zerberros/Class_D_Amp/Proyecto_Fin_de_Grado_Etapa_Amplificadora_de_Clase_D_Jairo_Estefania.pdf

## ESCUELA TÉCNICA SUPERIOR DE INGENIEROS INDUSTRIALES Y DE TELECOMUNICACIÓN

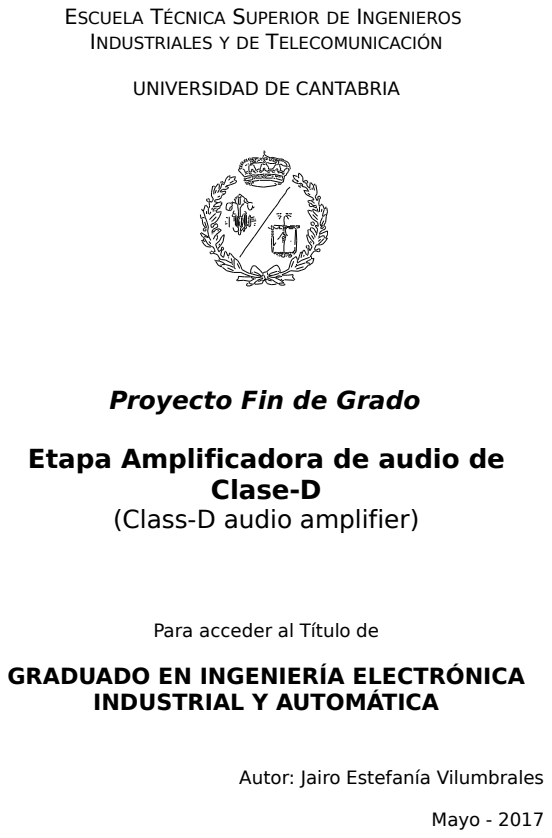
[picture p2: page 1]
Clase-D; INDUSTRIAL Y AUTOMÁTICA; Mayo - 2017

UNIVERSIDAD DE CANTABRIA

Proyecto Fin de Grado
Etapa Amplificadora de audio de

(Class-D audio amplifier)

Para acceder al Título de

GRADUADO EN INGENIERÍA ELECTRÓNICA

Autor: Jairo Estefanía Vilumbrales

Resumen

En este proyecto se ha diseñado y construido una etapa de potencia analógica de clase-D para audio.
Para el diseño, se ha usado un generador de señal triangular basado en un TLC555 y en fuentes de intensidad mediante transistores BJT. Seguidamente la señal es adaptada con algunos amplificadores operacionales y puertas lógicas. Para controlar los MOSFETs de potencia se han usado drivers de la familia ir2010. Finalmente, la señal es integrada mediante un filtro pasivo formado por 2 bobinas toroidales y unos condensadores. Es un prototipo muy versátil ya que con pocos cambios se puede conseguir pasar de una etapa mono a una estéreo. Además la potencia depende de la tensión en la fuente de alimentación y está limitada fundamentalmente de los disipadores de calor y los propios MOSFETs, por lo que también se puede adaptar a diferentes necesidades.
Por último cabe destacar que este proyecto no trata de la construcción de un equipo de audio completo, sino de sólo de la etapa de potencia, y es necesario añadir una fuente de alimentación, una etapa preamplificadora, y una suerte de salida formada una o varias cajas con sus correspondientes altavoces y sus filtros pasivos.

1

2

## Índice

I MEMORIA | 5
II ANEXOS | 25
III PLIEGO DE CONDICIONES | 81
IV PRESUPUESTO | 85

3

4

# Documento I

# MEMORIA

1

Jairo Estefanía | Amplificador de clase D

# Índice general

I MEMORIA | 1
1. Estado del arte | 5
2. Objeto | 7
3. Alcance | 8
4. Normas y referencias | 9
5. Definiciones y abreviaturas | 10
6. Requisitos de diseño | 11
7. Metodología | 12
8. Resultados finales | 18
9. Resumen del presupuesto | 19
mayo 2017 | Documento nº 1: Memoria | página 3 de 19

Jairo Estefanía | Amplificador de clase D
mayo 2017 | Documento nº 1: Memoria | página 4 de 19

Jairo Estefanía | Amplificador de clase D


Figura 1.1: Prototipo. Parte frontal

# 1 Estado del arte

Los amplificadores de transistores empezaron a comercializarse en los años 70. Desde entonces han sufrido una serie de lentos pero constantes cambios que llegan hasta nuestros días, y hoy en día, continúa siendo una tecnología que sigue evolucionando.

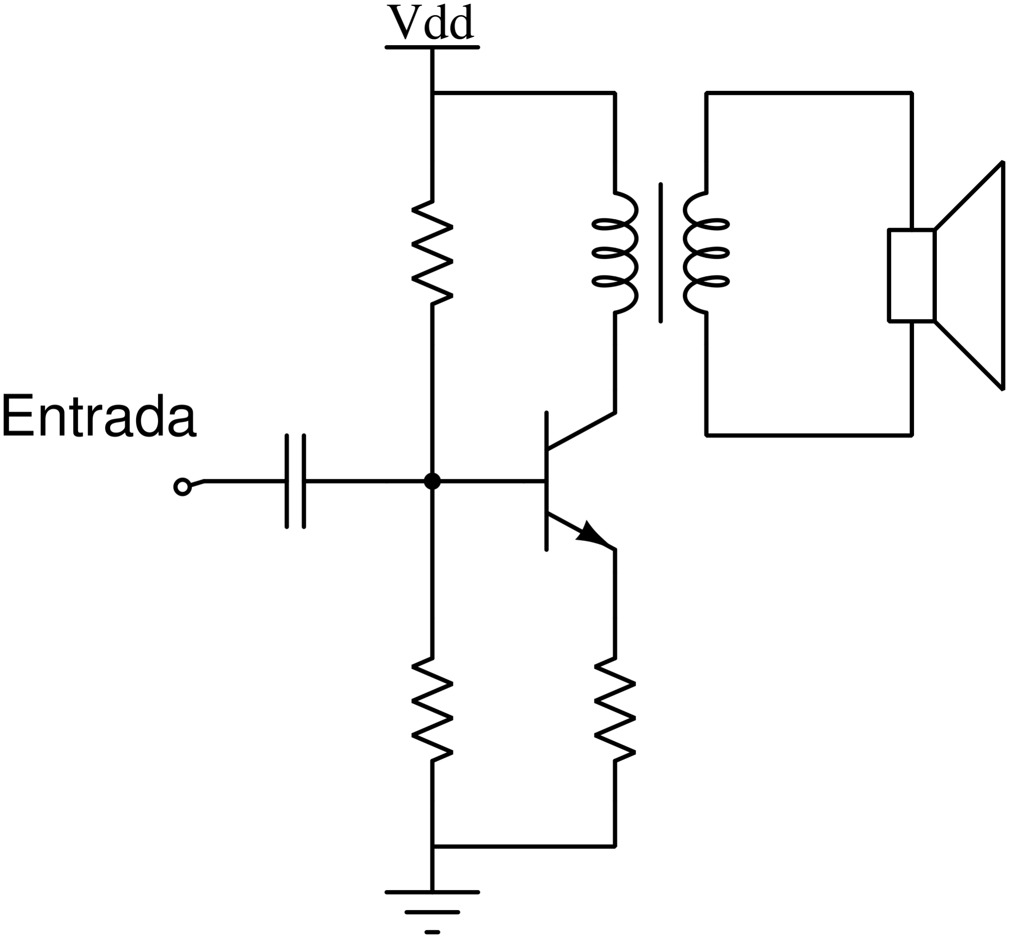
[picture p3: figure]

Figura 1.3: Amplificador de Clase-A

Los amplificadores o etapas de potencia son las encargadas de recibir una señal de un previo o preamplificador, amplificarla y acondicionarla para entregar la señal a los altavoces en forma de potencia. Debido a que los altavoces tienen por norma general una impedancia de 8Ω, las etapas de potencia deberán tener a su vez una una impedancia de salida pequeña, idealmente la misma que el altavoz, para poder entregar el máximo de potencia. Ver teorema de máxima transferencia de potencia [1].

mayo 2017 | Documento nº 1: Memoria | página 5 de 19

Jairo Estefanía | Amplificador de clase D

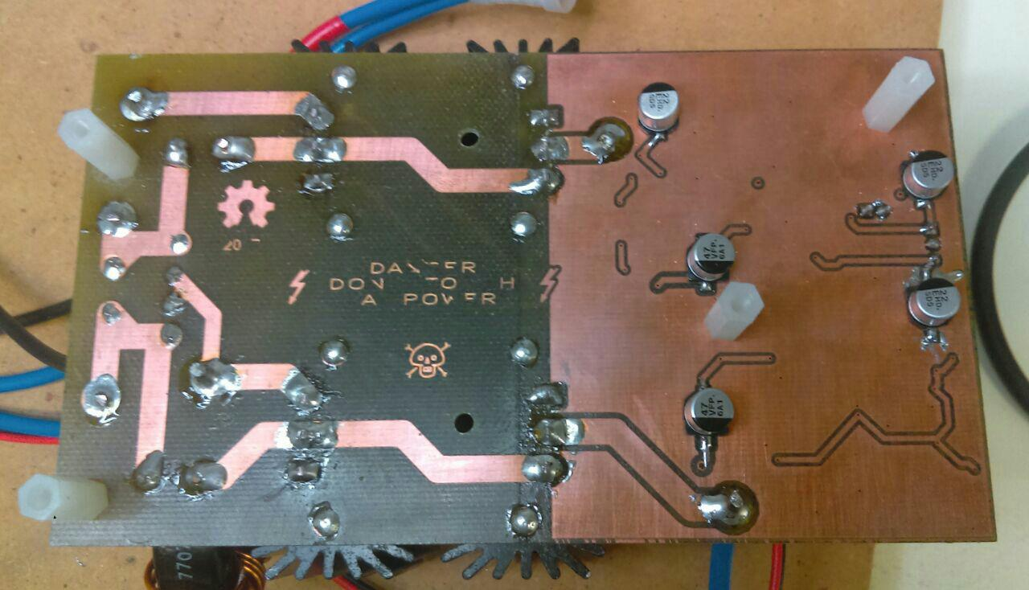
[picture p4: figure]

Figura 1.2: Prototipo. Parte trasera.

Los amplificadores Clase-A tienen una
alta linealidad pero poseen un rendimiento máximo del 50 %, y en algunos modelos con un rendimiento por debajo del 25 % por lo que su utilización se restringe a aplicaciones de menos de 1W, donde el rendimiento no es importante, o donde se necesite una gran linealidad [2].

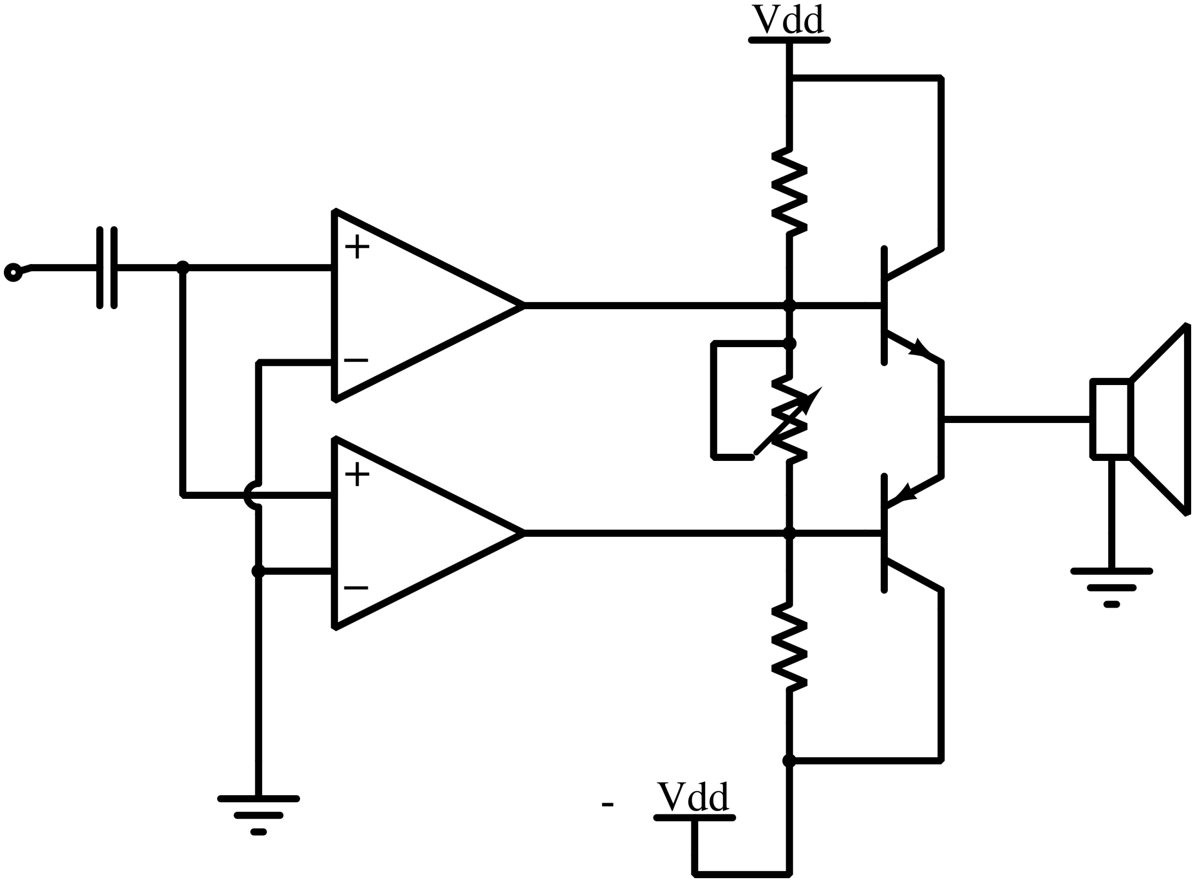
[picture p5: figure]
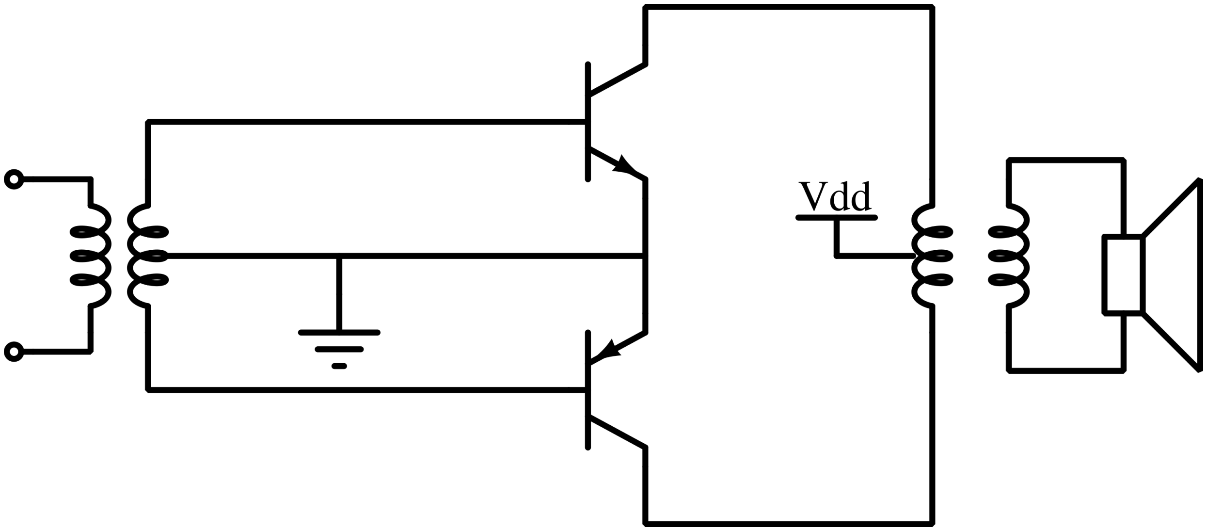
[picture p6: figure]

(a) Amplificador de Clase-B | (b) Amplificador de Clase-AB

Figura 1.4: Etapas de audio

En los amplificadores de Clase-B el rendimiento aumenta hasta el 78 % debido a que los transistores están polarizados en corte y cada transistor trabaja en un semiciclo de la señal de audio. Los amplificadores de Clase-B tienen una molesta distorsión por cruze que hace que en la práctica, no sean utilizados.

Los amplificadores de Clase-AB han sido y siguen siendo los más utilizados tanto en equipos profesionales como en equipos de consumo. Posee un gran compromiso entre linealidad y rendimiento. Su rendimiento es similar

mayo 2017 | Documento nº 1: Memoria | página 6 de 19

Jairo Estefanía | Amplificador de clase D

al de Clase-B 78.5 % sin embargo al polarizarse los transistores, se consigue mitigar la distorsión de cruze.

Los amplificadores de Clase-D han conseguido penetrar en un mercado donde los amplificadores de clase AB no lo han conseguido precisamente por su rendimiento. Esto son la microelectrónica para dispositivos móviles o con bateria, y el audio de alta potencia profesional, dirigido a eventos en directo, donde se usan etapas de más de 5000W.

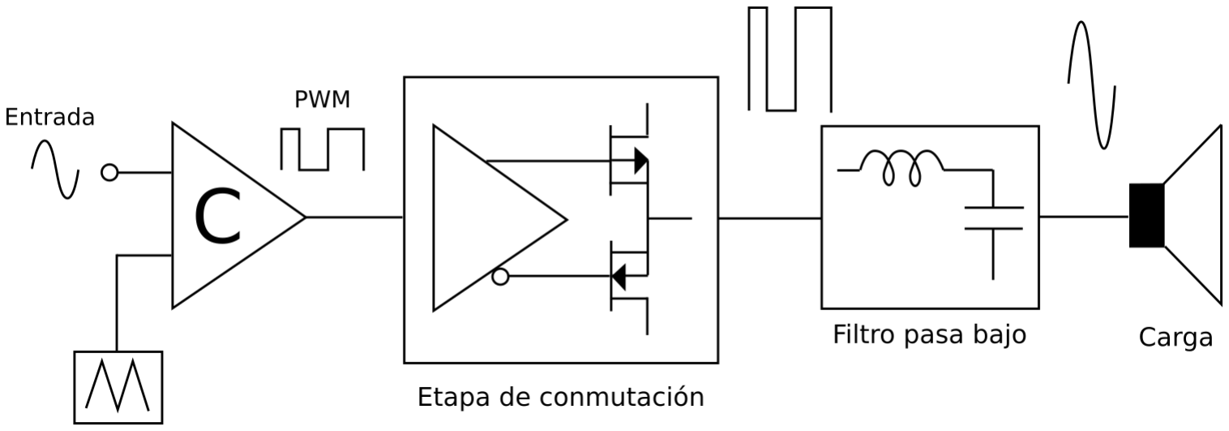
[picture p7: figure]

Figura 1.5: Esquema de funcionamiento de una etapa de clase-D. Fuente: Wikipedia

El funcionamiento de las etapas de clase D difiere por completo de las demás tipos de etapas. Su funcionamiento se basa en el muestreo o troceado de una señal de audio para obtener un mayor rendimiento en los transistores finales de salida. La frecuencia de muestreo debe ser mayor a las frecuencias de la banda de audio, para poder ser eliminada en un filtrado posterior sin que afecte a la calidad final.

Para conseguir el muestreo de audio, se pueden usar varias técnicas, cada una con sus convenientes e inconvenientes. Una de ellas consiste en ir comparando la señal de audio con una señal triangular para obtener una modulación PWM del sonido. Otra técnica consiste en utilizar un modulador Sigma-Delta para conseguir el mismo efecto.

# 2 Objeto

El presente proyecto abarca el diseño, simulación, y prototipado de una etapa amplificadora de audio de clase D, de mediana potencia y de propósito general.
Debido a la complejidad general, el proyecto ha sido dividido en 4 bloques funcionales, que son descritos brevemente a continuación:

Generador de señal triangular: Este bloque genera una señal triangu-

mayo 2017 | Documento nº 1: Memoria | página 7 de 19

Jairo Estefanía | Amplificador de clase D

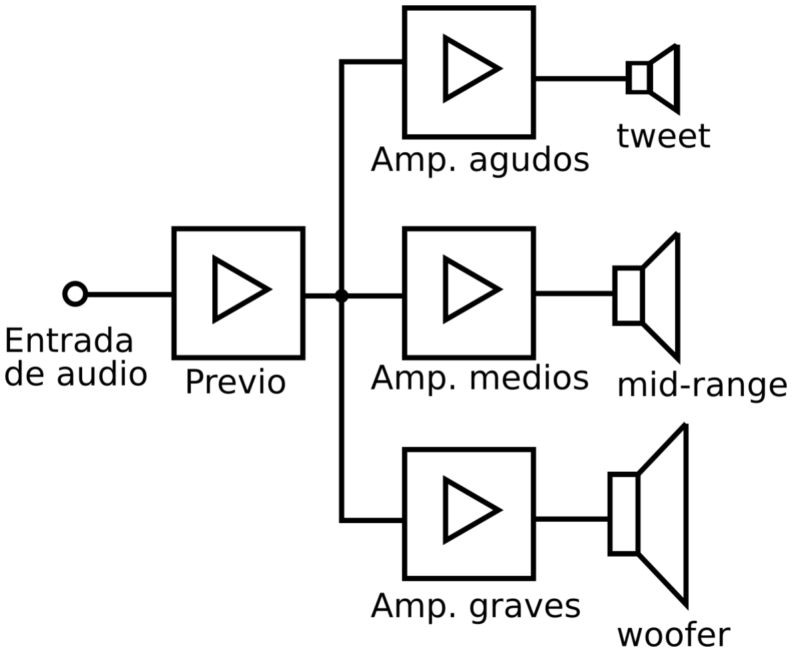
[picture p8: figure]

(a) Varias etapas con filtros activos

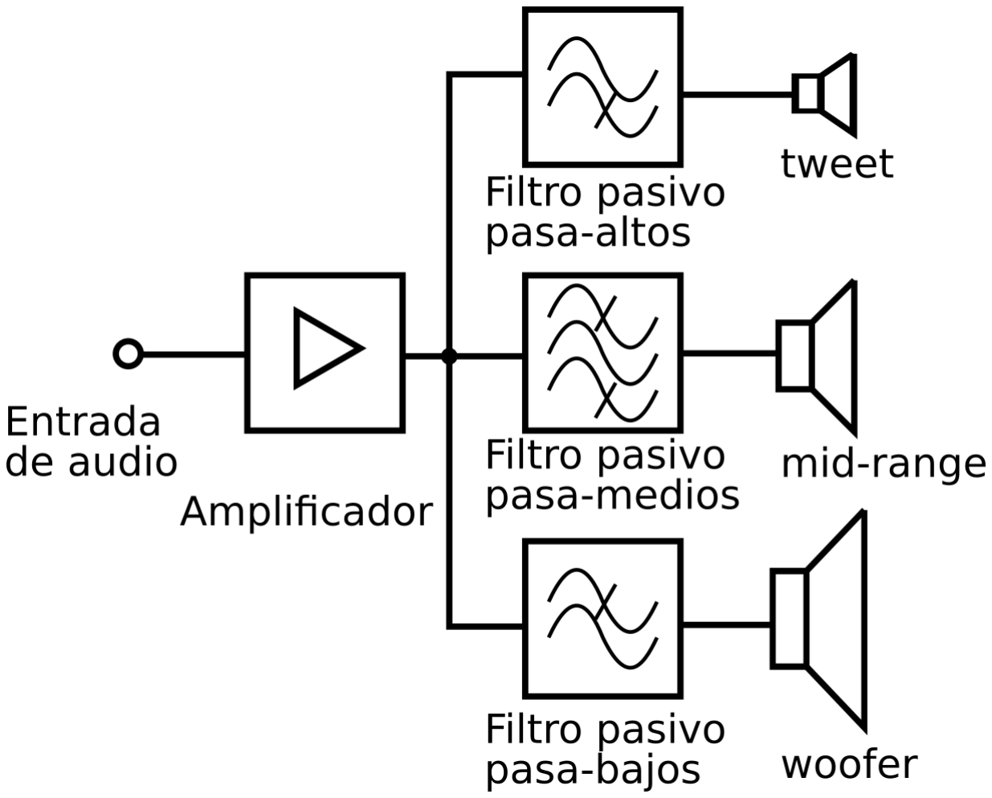
[picture p9: figure]

(b) Etapa con filtros pasivos

Figura 1.6: Sistemas de audio

lar de 5Vpp y 165kHz mediante dos fuentes de intensidad creadas con transistores BJT y gobernadas por un circuito integrado TLC555.

Generador de señales PWM: En esta segunda etapa, por una parte, se filtra la señal triangular para eliminar la componente contínua, y por otra parte, se recoge la señal de audio y se replica con ganancia −1. Finalmente se comparan las 2 señales de audio con la señal triangular para obtener 2 señales PWM, de las cuales, una está invertida y desplazada 180º.

Generador de tiempos muertos: Cada una se las señales PWM es replicada con ganancia −1 y se le añade unos ’tiempos muertos’ con el fin de evitar cortocircuitos de corriente en los MOSFETs de potencia.

Drivers y MOSFETs de potencia: Este bloque contiene 2 amplificadores TODO-NADA formado cada uno por un driver y 2 MOSFETs de tipo N. Los MOSFETs de cada amplificador deben conducir de manera alternativa para generar una señal PWM con la tensión de alimentación. Finalmente las 2 señales PWM de los 2 amplificadores son filtradas con un filtro pasivo formando 2 señales de audio invertidas entre si, que serán las que ataquen al altavoz.

Una vez construido el prototipo, se pretende realizar un análisis de distorsión armónica (THD), un análisis de rendimiento energético, y una valoración económica comparandolo con las diferentes soluciones del mercado.

# 3 Alcance

El alcance de este proyecto es el de poder incorporar ésta etapa de potencia en un equipo profesional o semiprofesional junto a una etapa preamplificadora, una fuente de alimentación y un sistema de salida de 3 o cuatro

mayo 2017 | Documento nº 1: Memoria | página 8 de 19

Jairo Estefanía | Amplificador de clase D

vias de audio con sus respectivos filtros pasivos.

Además se pretenden conseguir unos objetivos en cuanto al enriquecimiento personal:

Adquirir una idea sobre el estado actual del mercado de audio.

Adquirir habilidades necesarias para seguir construyendo productos relaccionados con el audio.

Obtener un producto preparado para competir en el mercado, y que sea fácilmente adaptable a diferentes productos finales (amplificador de guitarra, sistema estéreo autoamplificado, etc).

# 4 Normas y referencias

## 4.1. Disposiciones legales y normas aplicadas

### 4.1.1. Documentación

Normativa del Trabajo Fin de Grado, Universidad de Cantabria, 2013.

Normas Redaccion TFG Grado en Ingeniería Mecánica, Eléctrica y Electrónica Industrial y Automática

Norma UNE 157001-2014

### 4.1.2. Normas técnicas

Generic Standard on Printed Board Design [5]

IEEE Recommended Practice and Requirements for Harmonic Control in Electric Power Systems

## 4.2. Software

NGSPICE 26: Software para la simulación de circuitos electrónicos. Desarrollado inicialmente por la Universidad de California en Berkeley, y actualmente mantenido por una pequeña comunidad de software libre. Licencia BSD.

Python 3.6: Software utilizado para cálculos matemáticos y scripting, junto a las bibliotecas Jupyter, numpy, matplotlib, y Scipy. Licencias: PSF LICENSE (GPL-compatible), y derivadas.

mayo 2017 | Documento nº 1: Memoria | página 9 de 19

Jairo Estefanía | Amplificador de clase D

KiCad 4.0.6: Software utilizado para la creación de esquemáticos y diseño de PCB. Licencia GPL 3+.

LATEX 2ε: (ecosistema) Software utilizado para la documentación. Licencia MIT, LGPL, LaTeX Project Public License (LPPL), GPL.

FreeCad 0.16 Software de diseño 3D usado para crear algunos modelos 3D de componentes para KiCad.

Inkscape 0.92 Software de dibujo vectorial en 2D utilizado para la documentación. Licencia GPL.

git 2.12 Sistema de control de versiones. Licencia GPL v.2

## 4.3. Bibliografia

[1] V. M. y. O. Parra, TEORÍA DE CIRCUITOS I y II, U. Madrid, ed. 1991.
[2] J. C. Ginés, Equipos de sonido, E. C. 3, ed. 2001, isbn: 84-95391-82-1.
[3] R. Palmer, «Design Considerations for Class-D Audio Power Amplifiers», Texas Instruments, Application Report, ago. de 1999.
[4] R. W. Erickson y D. Maksimović, Fundamentals of Power Electronics. Kluwer academic, 2001, isbn: 0-7923-7270-0, 0-306-48048-4.
[5] I.-A. C. E. Industries, ed., IPC-2221, Generic Standard on Printed Board Design, feb. de 1998. dirección: www.ipg.org.
[6] B. Carter y R. Mancini, OP AMPS for everyone, T. Instruments, ed. 2009, isbn: 978-1-85617-505-0.
[7] W. N. Mohan T.M. Undeland, Power electronics.: converters, applications and design, J. Wiley, ed. 1995, isbn: 0-471-58408-8.
[8] J. Honda y J. Cerezo, «Class D Audio Amplifier Design», International rectifier, Application Report, 2003.

# 5 Definiciones y abreviaturas

Bridge mode: Configuración en puente: Sistema incorporado en etapas de potencia estéreo en el que uno de los canales se invierte de fase para alimentar sólo una salida, convirtiendo el sistema en mono y sumando en éste la potencia de los dos canales.

mayo 2017 | Documento nº 1: Memoria | página 10 de 19

Jairo Estefanía | Amplificador de clase D

Driver para MOSFETs: Circuito integrado encargado de generar tiempos muertos y/o cambiar la referencia de la señal en entrada, por la tensión de fuente del MOSFET, en los casos en los que la tensión de esta patilla sea diferente a GND.

Duty Cycle: Ciclo de Trabajo: Es la relación que existe entre el tiempo en que una señal PWM se encuentra en estado activo y el periodo de la misma.

K.I.S.S.: Keep It Simple Stupid : Filosofia de diseño originaria en la armada de los E.E.U.U. por los años 60, que reza que hay que mantener las cosas lo más simple posible, aunque parezca estúpido, con el fin de facilitar un buen mantenimiento y detección de errores.

PCB: Placa de Circuito Impreso: Es la superficie constituida por caminos, pistas o buses de material conductor laminadas sobre una base no conductora.

PWM: Modulación por Ancho de Pulsos: Es una técnica en la que se modifica el ciclo de trabajo de una señal cuadrada, para preansportar una información.

RMS: Valor Cuadrático Medio o valor eficaz: Es la raíz cuadrada de la media aritmética de los cuadrados de los valores. Se corresponte con
√

1
(2)

veces el valor pico de una señal de tensión o intensidad.

THD: Distrosión Armónica Total: Es un parámetro técnico utilizado para definir la cantidad de armónicos que el equipo introduce y que no estaban en la señal original.

# 6 Requisitos de diseño

## 6.1. Diseño ético

Todo el proyecto ha sido diseñado con software libre, y será liberado para que pueda ser estudiado por otras personas. De esta forma se contempla que en un futuro pueda existir un desarrollo del mismo a una mayor velocidad y con diferentes puntos de vista.

mayo 2017 | Documento nº 1: Memoria | página 11 de 19

Jairo Estefanía | Amplificador de clase D

## 6.2. Diseño estratégico

El proyecto se ha dividido en subcircuitos más pequeños en forma de módulos siguiendo el principio K.I.S.S. que se traduce como, ’mantenlo lo más simple posible’.
Los archivos de simulación y los archivos de los esquemáticos para su posterior proceso hacia el diseño de la PCB están fuertemente correlacionados, de tal forma que se pueda identificar unos con otros.
Por último se ha implementado un sistema de control de versiones medianta Git.

## 6.3. Diseño técnico

La etapa de potencia ha sido diseñada para trabajar con un alto rango de tensiones de entrada.
Por simplicidad sólo se ha contemplado un modo Bridge y una carga de 8Ω. Sin embargo resulta relativamente sencillo adaptar el diseño para hacer un amplificador estéreo, o para poder utilizar altavoces de distinta impedancia.
La PCB ha sido diseñada con tecnología SMD para conseguir la mayor reducción de tamaño posible y poder reducir gastos de fabricación.

# 7 Metodología

## 7.1. Funcionamiento General y modo Bridge

Los amplificadores de potencia de clase D, utilizan MOSFETs o IGBTs a modo de interruptores, que generan unas señales cuadradas que posteriormente se filtran para obtener la señal de audio que atacará a los altavoces. Ya que la carga de las etapas de audio es fija, -normalmente de 8Ω, pero puede ser de 4Ω o 2Ω poniendo varios altavoces en paralelo- , la potencia entregada a la salida depende exclusivamente de la tensión de la señal cuadrada generada por los MOSFETs, y por tanto, de la tensión de alimentación de la etapa.
La razón de utilizar los MOSFETS a modo de interruptores es la de la eficiencia. Cuando un transistor de potencia se encuentra en conducción la tensión entre sus terminales es prácticamente de cero voltios, mientras que si se encuentra en corte, la intensidad que pasa entre sus terminales también es cero. Por lo tanto si aplicamos la fórmula P = V · I, se comprueba que la potencia disipada en los transistores de potencia es mínima, en comparación con la potencia que llega a la carga.
mayo 2017 | Documento nº 1: Memoria | página 12 de 19

Jairo Estefanía | Amplificador de clase D

El modo Bridge consiste en alimentar al altavoz con dos tensiones invertidas respecto a una referencia virtual. Con ésta técnica se consigue alimentar el altavoz con una tensión virtual del doble.
Para hacer una etapa de potencia en modo Bridge es necesario doblar el número de transistores MOSFETS, ya que en vez de regular una tensión respecto a una referencia, se tiene que regular 2 tensiones.
Modulación: Fundamentalmente consiste en comparar una señal triangular a alta frecuencia con la señal de sonido. Dependiendo de el nivel de tensión de la señal de audio en un punto dado, se cortará antes o después con la señal triangular, lo que producirá una señal PWM con un duty cycle determinado.
Para una mejor calidad de sonido , o una mejora del nivel de distorsión armónica, la modulación de los MOSFETS que regulan la tensión de salida positiva, se modulan con la señal de audio sin modificar, mientras que la modulación que regula la tensión de salida negativa, se modula con la señal de audio invertida.

## 7.2. Alimentación

En la parte de control se necesita una alimentación de 15V DC para el TLC555, el disparador Schmitt 40106 y las puertas lógicas ’AND’ 14081. El amplificador operacional TL084 y el comparador LM319 necesitan alimentación dual de ±15V . Los driver ir2010 por un lado llevan 15V DC por la parte de control y otros 15V DC para la parte de potencia. La alimentación de los MOSFETs también debe ser contínua y dependerá de la potencia que se pretenda ofrecer a la salida.

## 7.3. Generador de señal triangular

Para generar una señal triangular se ha utilizado un circuito integrado TLC555 en modo astable, cuya salida se invierte mediante los BJT Q1 y Q8. La señal invertida sirve para polarizar alternativamente los BJT Q2 y Q3 que funcionan a modo de fuente de intensidad. A través de las resistencias R3 y R4 y los 2 diodos zener se obtiene el valor de tensión en puerta deseado para la polarización, en este caso 3,6V . Mediante las resistencias R5 y R6 se regula la fuente de intensidad que se encarga de cargar y descargar el condensador C2 y producir la señal triangular. Cuando la tensión del condensador alcanza 1/3 y 2/3 de Vcc, el TLC555, realimentado por la patilla 6 y 2, invierte su salida.

mayo 2017 | Documento nº 1: Memoria | página 13 de 19

Jairo Estefanía | Amplificador de clase D

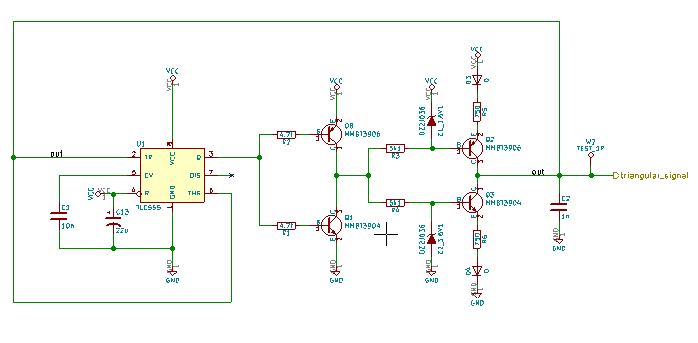
[picture p10: figure]

Figura 7.1: Generador de señal triangular

## 7.4. Generador de señal PWM

### 7.4.1. Adaptación de impedancia y filtrado de componente

contínua en la señal triangular

El amplificador operacional TL084 U2D (Fig: 7.2) es configurado como seguidor de tensión, ya que es necesaria una impedancia idealmente infinita para no producir ningina atenuación en la señal triangular.
El amplificador operacional U2C actúa como filtro pasa-alto, con una ganancia unidad en altas frecuencias y una frecuencia de corte situada aproximadamente en los 1,2KHz con lo que se elimina la componente contínua de la señal.

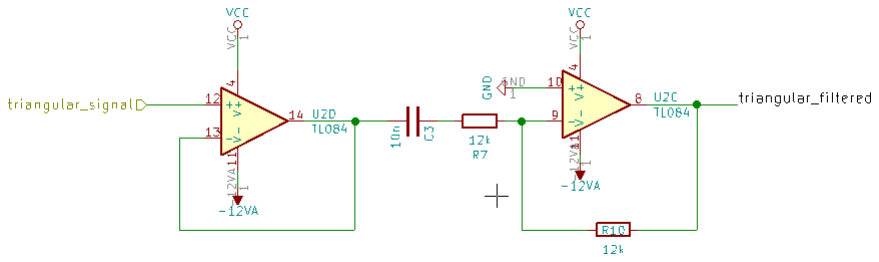
[picture p11: figure]

Figura 7.2: Filtrado de componente contínua a la señal triangular.

mayo 2017 | Documento nº 1: Memoria | página 14 de 19

Jairo Estefanía | Amplificador de clase D

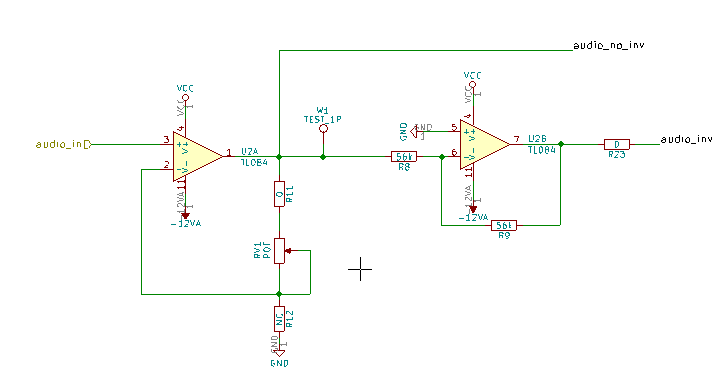
[picture p12: figure]

Figura 7.3: Entrada de audio

### 7.4.2. Entrada de audio

El amplificador operacional U2A (Fig: 7.3) funciona como seguidor de tensión pero cambiando el valor de las resistencias R11 y R12 se puede añadir algo de ganancia, que además se puede ajustar con la resistencia variable
RV 1 [6].
El amplificador operacional U2B (Fig: 7.3) está configurado como amplificador inversor de ganancia unidad. Las resistencias R8 y R9 tienen un valor lo suficientemente alto para no atenuar la señal. La resistencia R23 no tiene ninguna función y está colocada para hacer de puente en la PCB.

### 7.4.3. Comparadores

En la figura 7.4 se observa como se obtiene las señales PWM a partir de la señal triangular y las señales de audio. El circuito integrado LM319 es un comparador con colector abierto, por lo que es necesario colocar las resistencias R13 y R14. La generación de los PWM en fase y en contrafase tiene un sentido, y es que ésta técnica de modulación reduce considerablemente el contenido de armónicos en la salida [7].

## 7.5. Generación de tiempos muertos

Las señales Hinfase y Linfase de la figura 7.5 son las encargadas de conmutar una de las salidas con la tensión de alimentación de potencia V EE y con GNDPW R respectivamente, por lo que en ningún momento pueden estar las 2 en estado alto. Además, debido a que los MOSFETs tienen un tiempo de corte mayor que el de puesta conducción, es necesario introducir un tiempo muerto o ’dead time’ en las transiciones de conducción.

mayo 2017 | Documento nº 1: Memoria | página 15 de 19

Jairo Estefanía | Amplificador de clase D

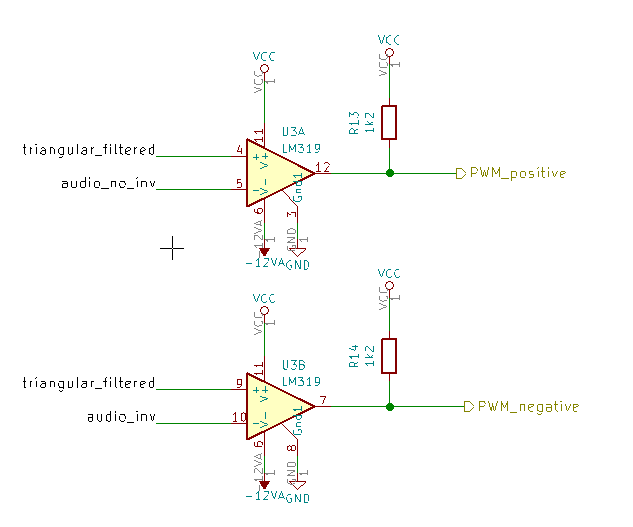
[picture p13: figure]
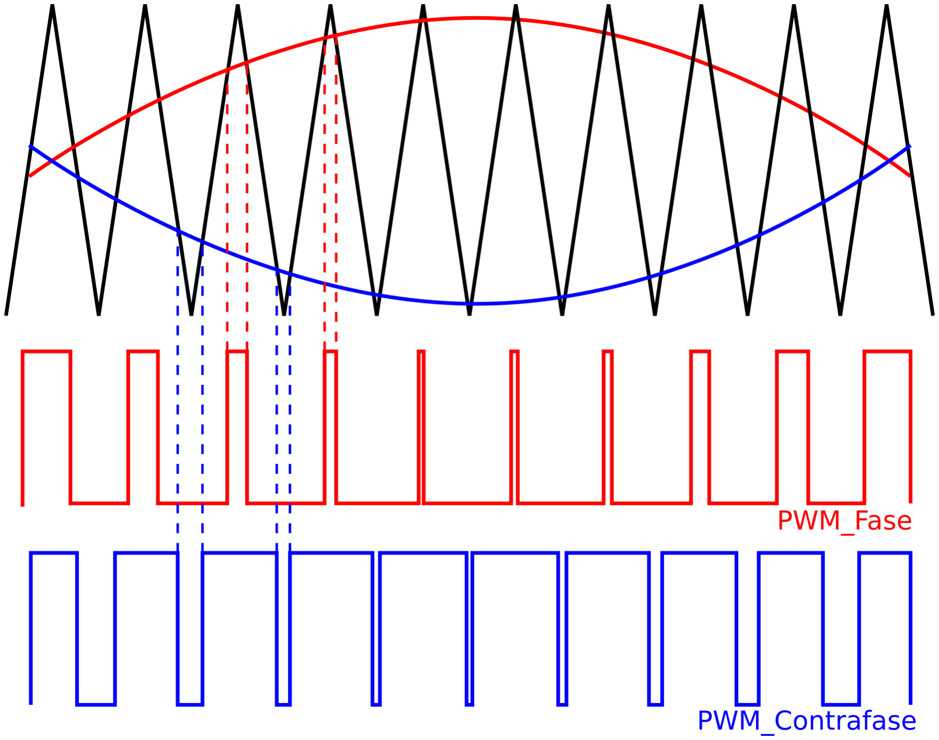
[picture p14: figure]

(a) Comparadores LM319 | (b) Señales PWM a partir de una se- ñal triangular y una señal de audio

Figura 7.4: Generación de PWM mediante comparadores

Para generar los tiempos muertos se usa una red RC y un disparador de Schmitt. Cuando se produce un flanco de subida, el condensador se empieza a cargar con la intensidad limitada mediante la resistencia. Cuando el condensador alcanza la tensión de histéresis del disparador, éste cambia su salida, pudiendose controlar así, los tiempos muertos cambiando los valores del condensador y/o la resistencia. Hay que tener en cuenta que el disparador de Schmitt ofrece una intensidad de salida limitada a 6mA, por lo que se debe tener que poner un valor de resistencia relativamente alto, y un valor de condensador relativamente bajo.
Observese en la figura que para que una de las puertas AND tenga una salida en estado alto, una de las patillas de entrada tiene que estar en estado alto mientras que la otra entrada la misma señal pasa necesariamente por la red RC (y se niega 2 veces.)

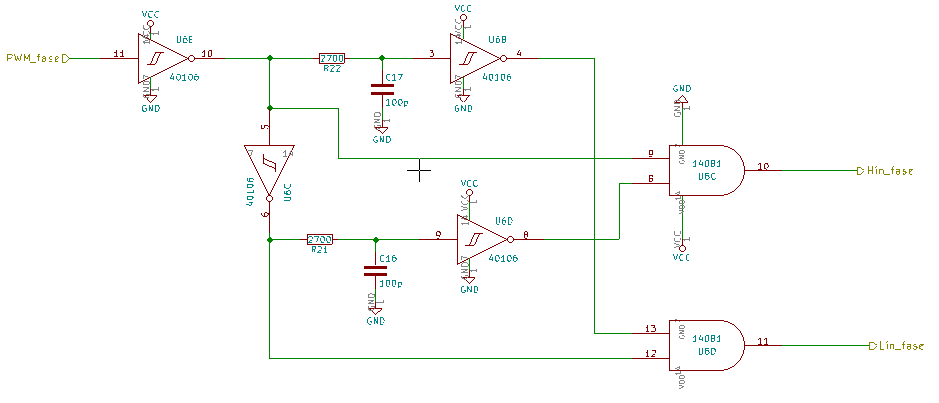
[picture p15: figure]

Figura 7.5: Generación de tiempos muertos.

mayo 2017 | Documento nº 1: Memoria | página 16 de 19

Jairo Estefanía | Amplificador de clase D

## 7.6. Driver de potencia y Mosfets

### 7.6.1. Drivers ir2010

Los drivers tienen 2 funciones fundamentales; La primera es la de poder elevar la referencia de tensión para la tensión de puerta en caso de que el MOSFET se encuentre ’flotando’. La segunda es la de crear un tiempo muerto para que no se produzca cortocircuito en corriente, aunque en este caso, el driver ir2010 no proporciona un tiempo muerto lo suficientemente grande, y es necesario contar con el circuito auxiliar que haga esta función. Para poder mantener una tensión de puerta para el MOSFET alto, el driver se basa en un condensador llamado condensador bootstrap (CBOOT ), y en un diodo, llamado diodo bootstrap (Dbs). Cuando el MOSFET bajo se encuentra conduciendo, la referencia Vs es próxima a cero, y el condensador CBOOT se carga a través del diodo Dbs a la tensión Vcc. Una vez que el MOSFET de abajo entra en corte, la tensión Vs deja de estar a cero voltios, y el condensador CBOOT es descargado a través de VB y HO a la capacidad de puerta del MOSFET alto, haciendo que éste entre en conducción. Ver figura 7.7.

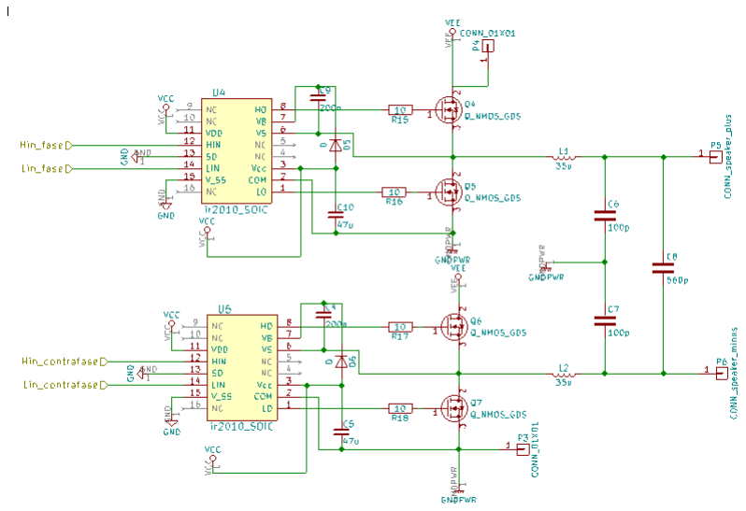
[picture p16: figure]

Figura 7.6: Drivers, MOSFETs e integrador

### 7.6.2. MOSFETs

Como se ha podido observar antes, los MOSFETs son los encargados de crear una conmutación a GNDPW R y a V EE alternativamente para crear una señal PWM de potencia que atacará al altavoz. Por lo tanto la elección

mayo 2017 | Documento nº 1: Memoria | página 17 de 19

Jairo Estefanía | Amplificador de clase D

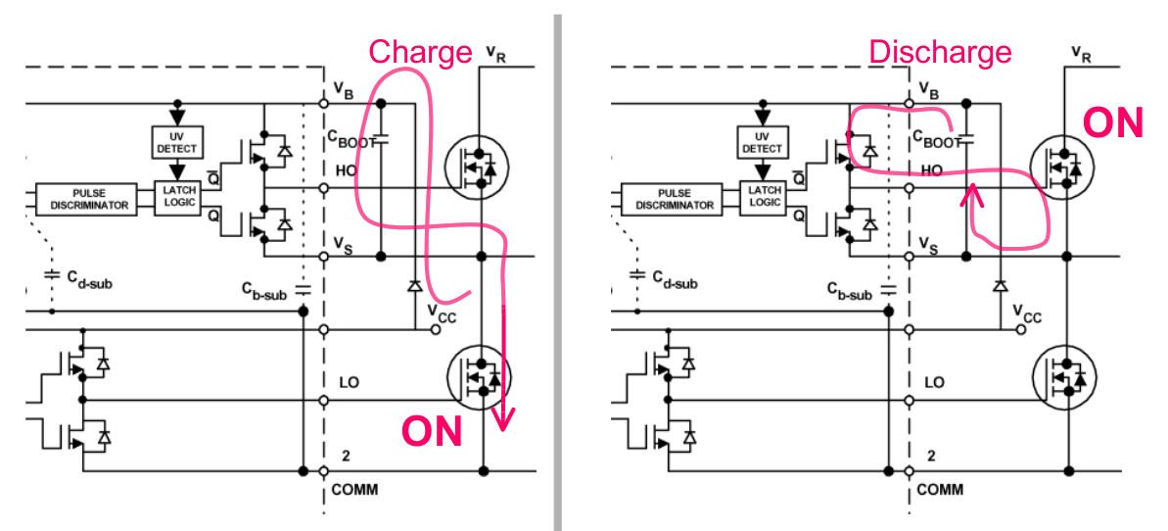
[picture p17: figure]

Figura 7.7: Técnica ’Boot strap’ para la polarización del MOSFET en el lado alto.Imagen del articulo ’Class-D Audio Amplifier Design’ de IR.[8]

de unos MOSFETs de calidad es fundamental para un buen funcionamiento del circuito.
Los parámetros más importantes del MOSFET, son la resistencia de conducción llamada Rdson, y los tiempos de conmutación.
Para este tipo de aplicaciones es crucial que los MOSFETs tengan una resistencia de conducción lo más baja posible ya que éste parámetro indica la cantidad de energía que se va a desperdiciar en forma de calor, y por consiguiente, condiciona el tamaño de los disipadores de calor y el rendimiento del circuito.

### 7.6.3. Filtrado

El objetivo del filtro de salida es la atenuación de la componente de alta frecuencia producido por los MOSFETs preservando la señal en la banda de audio. [3]
Un filtro de segundo orden produce una atenuación de 40dBs por década, lo que significa que se tiene la frecuencia de corte en 25kHz y la frecuencia de conmutación en 165kHz se produce una atenuación de 32,8dBs, o lo que es lo mismo, una señal de 100V se reduce a una señal de 2,32V .
Si se desea incrementar la atenuación, existen dos alternativas: implementar un filtro de mayor orden, o aumentar la frecuencia de conmutación.

# 8 Resultados finales

Tras realizar los pertinentes ensayos en el laboratirio, se ha llegado a la conclusión de que los resultados son sorprendentemente buenos, a pesar de algunos pequeños fallos, y una generación de tiempos muertos excesivamente largos.

mayo 2017 | Documento nº 1: Memoria | página 18 de 19

Jairo Estefanía | Amplificador de clase D

No se ha podido realizar un análisis THD, debido a la dificultad de realizar una medición fiable.

# 9 Resumen del presupuesto

El coste total del proyecto asciende a oncemil ciento cincuenta con doce euros. 11.150,12e

mayo 2017 | Documento nº 1: Memoria | página 19 de 19

# Documento II

# ANEXOS

1

Jairo Estefanía | Amplificador de clase D

# Índice general

II ANEXOS | 1
A. Cálculos | 7

A.9. Potencia máxima en función del driver de los Mosfets . . . . 13

A.11.Potencia máxima en función de la intensidad de drenador de

B. Ficheros de Simulación (ngspice) | 17
C. Ensayos | 29
mayo 2017 | Documento nº 2: Anexos | página 3 de 55

Jairo Estefanía | Amplificador de clase D
C.5.4. 50V | 36
C.6. Carga de 10,8Ω | 37
C.6.1. 40V | 37
C.6.2. 50V | 38
C.6.3. 60V | 39
C.6.4. 70V | 40
C.7. Cámara térmica | 41
C.8. Conclusiones | 41
D. Esquemáticos | 43
Esquema de bloques | 43
Generador de señal triangular | 45
Generador de señales PWM | 46
Generador de tiempos muertos | 47
Drivers y MOSFETS de potencia | 48
E. Ficheros PCB y Gerbers | 49
Capa de cobre ’Top’ | 49
Capa de cobre ’bottom’ | 51
Capa de taladros | 52
Posición de componentes | 52
F. Análisis de competencia | 53
F.1. the t.amp Proline 3000 | 53
F.2. the t.amp E-800 | 53
F.3. Behringer KM750 | 54
F.4. Crown XLS 2500 | 54

# Índice de figuras

A.1. Regulación de fuente de intensidad | | 7
A.2. Generador de tiempos muertos | | 8
A.3. Tensión-Potencia | 10
A.4. Intensidad máxima en la bobina | 11
A.5. Medio filtro de salida | 11
A.6. Filtro completo | 12
B.1. señal triangular | 18
B.2. filtrado de la señal triangular | 21
B.3. Filtrado de señal triangular y generación de PWM | 21
B.4. Generador de tiempos muertos | 24
B.5. Salida del circuito con unos tiempos muertos de 350ns . . . . 26
B.6. Salida del circuito con unos tiempos muertos de 30ns | 26
C.1. Señal trianguar | 29
mayo 2017 | Documento nº 2: Anexos | página 4 de 55

Jairo Estefanía | Amplificador de clase D
C.2. Modulacion | 30
C.3. Tiempos muertos | 31
C.4. Tension VGS en los MOSFETS | 32
C.5. Tensión de 20V. Irms = 1,2A | 33
C.6. Tensión de entrada: 30V . IRMS = 1,75A | 34
C.7. 10kHz | 35
C.8. Tensión de entrada: 50V . IRMS = 3,30A | 36
C.9. 40V | 37
C.10.50V | 38
C.11.Tensión de entrada: 60V . IRMS = 2,3A | 39
C.12.Tensión de entrada: 70V . IRMS = 2,65A | 40
C.13.Imágen térmica | 41
F.1. t.amp Proline 3000 | 53
F.2. the t.amp E-800 | 53
F.3. Behringer KM750 | 54
F.4. Crown XLS 2500 | 54
mayo 2017 | Documento nº 2: Anexos | página 5 de 55

Jairo Estefanía | Amplificador de clase D
mayo 2017 | Documento nº 2: Anexos | página 6 de 55

Jairo Estefanía | Amplificador de clase D

# Anexo A: Cálculos

Todos los cálculos están pensados para una carga de 8 Ω en configuración puente.

## A.1. Cálculos para la generación de la señal triangular

Io
C

=

∆V
t

(A.1)

C = 1nF; | ∆V = 5V ; | t =

1
2·250000

Io = 1 · 10−9

- 5 · 210 · 10−6 = 2,5mA

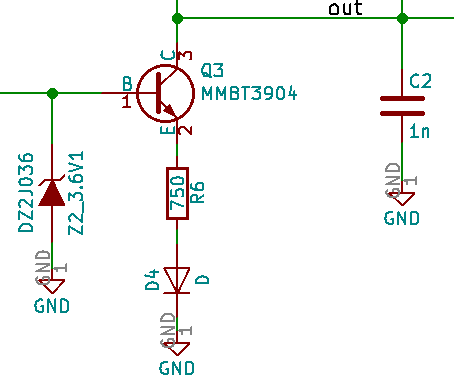
[picture p18: figure]

Figura A.1: Regulación de fuente de intensidad.

Vzener = Vbc + Io · R + Vd | (A.2)

3,6 = 0,8 + 0,0025 · R + 1V

R =

3,6−0,8−1
0,0025 = 720Ω

Nota: tanto las tensiones de base-emisor del BJT, como las de los diodos son aproximadas.

## A.2. Cálculo del tiempo muerto mínimo necesario

Tiempos de propagación en el driver ir2010:
ton = tiempo de propagación de encendido = 95ns
tr = tiempo de subida = 10ns
mayo 2017 | Documento nº 2: Anexos | página 7 de 55

Jairo Estefanía | Amplificador de clase D

tof f = tiempo de propagación en el apagado = 65ns
tr = tiempo de bajada = 15ns

Tiempos de propagación en el MOSFET:
td(on) = 30ns
tr = 25ns
td(of f) = 80ns
tf = 22ns
Tiempo total de encendido = 160ns
Tiempo total de apagado = 182ns

Tiempo muerto mínimo necesario = 22ns

## A.3. Cálculo de la generación de tiempos muertos

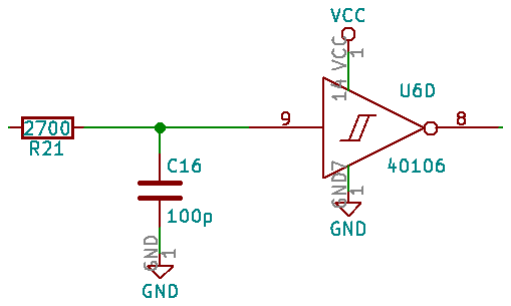
[picture p19: figure]

Figura A.2: Generador de tiempos muertos.

Vt = Vo

(
1 − e

− t
τ

)
(A.3)

τ = RC

Vt = tensión en función del tiempo.

V0 = tensión de carga en C.

En un tiempo t, la tensión Vt tiene que ser igual a la tensión de histéresis en el flanco de subida del comparador Schmitt. Para un tiempo muerto de 250ns y con un condensador de 100pF:

τ =

−t
ln(
1−

Vt
Vo

) = 3,10 · 10−7

Por lo tanto:
R =

τ
C = 3100Ω
mayo 2017 | Documento nº 2: Anexos | página 8 de 55

Jairo Estefanía | Amplificador de clase D

Para un tiempo muerto de 30ns y con una resistencia de 2700Ω:

τ =

−t
ln(
1−

Vt
Vo

) = 3,29 · 10−8

Por lo tanto:

C =

τ
R = 12,57pF

## A.4. Cálculo de tensión de la fuente de alimentación

Se debe tener en cuenta, es que la etapa de potencia de sonido tiene una configuración en puente, lo que significa que es necesario la mitad de tensión que en una configuración simple.

Cálculos para una potencia de 1000W

P =

V

2

R

(A.4)

VRMS =

√
P · R =

√
8000 = 89,44VRMS

Vp =

VRMS √
2

= 126,49V

Suponiendo una eficiencia de un 85 % en la dinámica de los MOSFETs.

Vg =

126,49
0,85 = 148,49V

Por lo que para conseguir una potencia en la salida de 1000W se deberá usar una fuente de tensión de 150V

mayo 2017 | Documento nº 2: Anexos | página 9 de 55

Jairo Estefanía | Amplificador de clase D

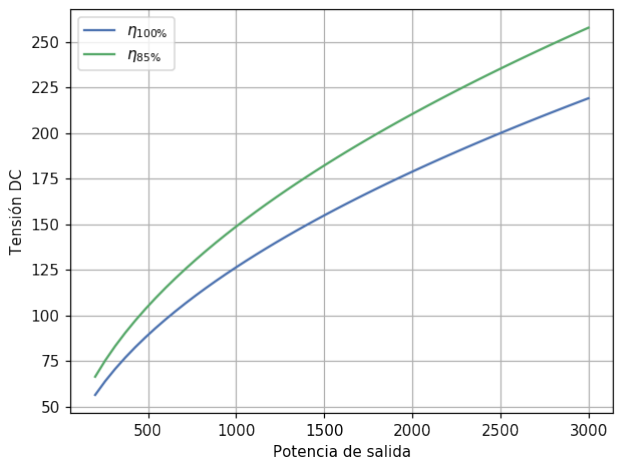
[picture p20: figure]

Figura A.3: Tensión-Potencia

## A.5. Cálculos de Intensidades de carga

Partiendo de una fuente de 150V , el caso más desfavorable es cuando el Mosfet superior de arriba y el Mosfet inferior de abajo estén conduciendo, por lo que la tensión de la fuente pasará directamente a la carga de 8Ω, es decir, la intensidad que deberá soportar los Mosfets es de:

Ip =

√
P
R
- sqrt2

Ip =

√
P
R =

1000V
8Ω · sqrt2 = 15,81A

Si se considera un factor de modulación del 85 % será de:

IpM=0,85 =

15,81
0,85 = 12,8A

## A.6. Cálculo del filtro de salida

El filtro de salida es un filtro simple de segundo orden LC Butterworth.

mayo 2017 | Documento nº 2: Anexos | página 10 de 55

Jairo Estefanía | Amplificador de clase D

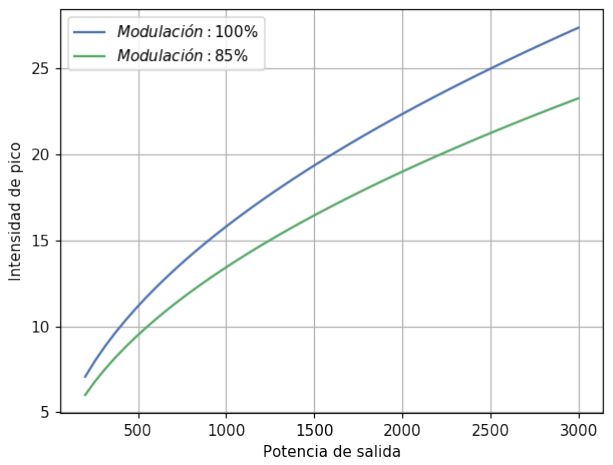
[picture p21: figure]

Figura A.4: Intensidad máxima en la bobina

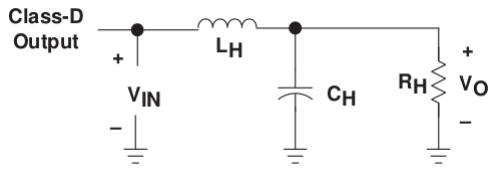
[picture p22: figure]

Figura A.5: Medio filtro de salida

G(s) = | ω

2
n
s
| 2 + 2δωns + ω²
n

(A.5)

VL = Vo

1
LC
s

2 + s

1
ZC +

1
LC

(A.6)

CH =

1
√
(2) · RH

=

1
2πfc

√
2RH

LH =

1
CH

=

√
2 · RH =

√
2RH
2π · fc
mayo 2017 | Documento nº 2: Anexos | página 11 de 55

Jairo Estefanía | Amplificador de clase D

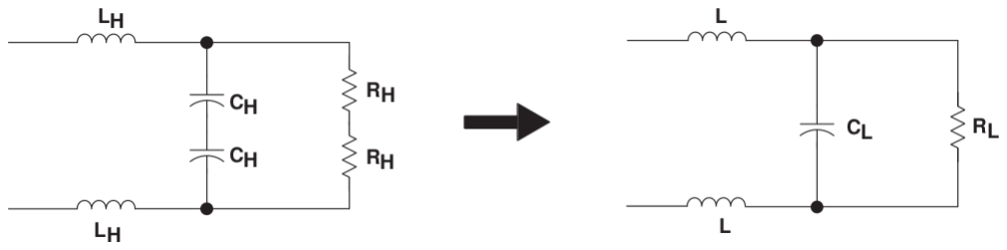
[picture p23: figure]

Figura A.6: Filtro completo

RL = 2 · RH = 8Ω

CL =

1
s

√
2πRLfc

= 560p

L = LH = 35µH

La frecuencia de corte :
fc =

1
2π

√
2·LCL

= 25kHz

## A.7. Cálculo de la inductancia

Se necesita calcular el número de vueltas para crear una inductancia con un core toroidal 0077071A7 cuyas especificaciones son:
Diámetro mayor: D = 32,8mm
Diámetro menor: d = 20,1mm
Altura: h = 10,7mm
Permeabilidad relativa: µr = 60
Codo en la curva de histéresis ≈ 1200T eslas

L =

µ0N²A

2πR

(A.7)

Área de la sección del Core = h ·

D−d
2 = 0,24cm²
Radio d
2 = 10,05mm
Permeabilidad del vacio µ0 = 4 · 10−7
- π
Permeabilidad = µ0 · µr = 7,53e − 5 Número de vueltas N =

√L·2·2·π·R

µ·Ac

= 21
Intensidad máxima I = 15,81A Teslas B =

µ·N·I
2·π·R = 0,4
Calibre AWG recomendado = 10

## A.8. Cálculo de rendimiento

La resistencia de conducción en los MOSFETs es de 0,4Ω, y la resistencia de las bobinas de 0,3Ω, suponiendo una potencia de entrada de 1kW

mayo 2017 | Documento nº 2: Anexos | página 12 de 55

Jairo Estefanía | Amplificador de clase D
Rdson = 0,4 | RL = 0,3

∑ R = 2 · Rdson + 2 · RL + R = 9,4Ω

I =

√
∑

Pin
R

= 10,314A

Pout = I

2

- R = 10,314²
- 8 = 851,06W

η =

Pout
Pin
- 100 = 85 %

Para aumentar el rendimiento, la solución más sencilla y barata, es la de aumentar el calibre AWG de la bobina para disminuir su resistencia. La otra opción es poner unos MOSFETs mejores con una menor resistencia de conducción.

## A.9. Potencia máxima en función del driver de los Mosfets

Los drivers ir2010 soportan una tensión en la parte de potencia de 200V , por lo tanto, la potencia máxima será 5kW.

P =

V

2
R =

200²
8 = 5000W

## A.10. Potencia máxima en función del ancho de pista

I = K · ∆T

0,44
- (W · H)
0,725 | (A.8)

I = Intensidad máxima en Amperios
K = 4.934 para pistas externas y 9.868 para pistas externas
∆T = Aumento de la temperatuta sobre la ambiente en ºC
W, H = Ancho y grosor en mm

Suponiendo una temperatura máxima de 50C sobre una temperatura ambiente de 30C, y teniendo en cuenta que se ha puesto una pista de 4mm:

I = K · ∆T

0,44
- (W · H)

0,725 = 8,864A

PMAX = I

2
- R = 629W

Para aumentar la potencia, una solución seria poner pistas de 70µm de espesor, con ello podriamos pasar hasta 1717W. Otra solución seria estañar las pistas.

mayo 2017 | Documento nº 2: Anexos | página 13 de 55

Jairo Estefanía | Amplificador de clase D

## A.11. Potencia máxima en función de la intensidad de drenador de los MosFets

Según el datasheet de los MOSFETs IXFH 36N60P, éstos aguantan una corriente de 36A. Por lo tanto, la poetncia máxima será de 10kW.

P = I

2

- R = 36²
- 8 = 10368W

## A.12. Potencia máxima en función de la disipación térmica

Para la disipación térmica de los MosFets se ha escogido un disipador de la serie 647 con 50.8mm de altura, cuyo coeficiente de disipación térmica es de 2.5ºC/W.

Tj − Ta = Pd (Rjc + Rcs + Rd) | (A.9)

Siendo:
TjMAX: temperatura máxima que puede alcanzar el silicio. Tj : temperatura del silicio en funcionamiento
K: coeficiente de seguridad
Ta: temperatura ambiente
Pd: Potencia térmica disipada
Rjc: Resistencia térmica entre el dado de silicio y el encapsulado
Rcs: Resistencia térmica entre el encapsulado y la pasta conductora.
Rd: Resistencia térmica del disipador

Suponiendo una temperatura ambiente de 30ºC, y con un coeficiente de seguridad de 0.75, tenemos que disipar:

Tj = TjMAX · K = 150 · 0,75 = 112,5C

Pd =

Tj−Ta
Rcj+Tcs+Rd

= 23,57W

Los Mosfets que se han escogido tienen una resistencia de conducción de 190mΩ, pero el fabricante nos dice que a temperatura de trabajo, esa resistencia se puede doblar, por lo que la intensidad que podemos hacer circular por los mosfets es de:

Irms =

√ Pd

Rdson

= 7,88A

Por lo que se podrá transferir una potencia al altavoz de:

mayo 2017 | Documento nº 2: Anexos | página 14 de 55

Jairo Estefanía | Amplificador de clase D

P = I

2
rms · RL = 496W

Para aumentar la potencia que podemos entregar, hay 2 posibles soluciones:

La primera consiste en doblar el número de Mosfets y ponerlos en paralelo. Ésto es posible por que los Mosfets tienen un coeficiente resistivo positivo con la temperatura. Sin embargo, se deberá tener en cuenta la intensidad máxima que puede dar el driver a la puerta del mosfet, teniendo que sustituir la resistencia de puerta por una mayor haciendo que aumente el tiempo de encendido y apagado del mosfet.
Con éste cambio logramos doblar la potencia ofrecida.

La otra solución es cambiar los mosfets por otros con una menor resistencia de conducción. Con los Mosfets C2M0025120D de WolfSpeed, podremos llegar a potencias de más de 4700W (Por criterio de disipación térmica, y con los mismos disipadores).

Las dos soluciones son compatibles.

mayo 2017 | Documento nº 2: Anexos | página 15 de 55

Jairo Estefanía | Amplificador de clase D
mayo 2017 | Documento nº 2: Anexos | página 16 de 55

Jairo Estefanía | Amplificador de clase D

# Anexo B: Ficheros de Simulación (ngspice)

## B.1. Generador de señal triangular

.TITLE Generador de onda triangular

********************************************************************************
* | Descripcion: Generador de señal triangular de 250kHz
* | a partir de un TCL555. Importante que sea TCL para altas frecuencias.
********************************************************************************

.INCLUDE lib/555_jai_model.sub
.INCLUDE lib/third_party.lib
V1 vcc 0 15 | ;Alimentacion
X_triangular_signal vcc out TRIANGULAR_SIGNAL | ;Circuito

.LIB 555
.SUBCKT TRIANGULAR_SIGNAL vcc out_555 | ;Subcircuito

R1 n3 b_q1 4700
R2 n3 b_q8 4700
R3 c_q1 b_q2 5100
R4 c_q1 b_q3 5100
R5 k_d1 e_q2 750
R6 e_q3 a_d2 750
R7 n7 0 1000

C01 n5 GND 15p IC=10
C02 out_555 GND 1n IC=7.5
*d_z1 b_q2 vcc | diode_z
*d_z2 0 | b_q3 | diode_z

a_zener1 b_q2 vcc dzener
a_zener2 GND b_q3 dzener

x_dio1 vcc k_d1 1N4148
x_dio2 a_d2 GND 1N4148
mayo 2017 | Documento nº 2: Anexos | página 17 de 55

Jairo Estefanía | Amplificador de clase D

Q02 out_555 b_q2 e_q2 2N3906
Q03 out_555 b_q3 e_q3 2N3904
Q01 c_q1 b_q1 GND 2n3904
Q08 c_q1 b_q8 vcc 2N3906
x_555 GND out_555 n3 vcc n5 out_555 n7 vcc 555 | ;modelo 555
.ENDS | ;Fin Subcircuito

.model diode_z D(Cjo=5p bv=3.6 Ibv=5m)
.model dzener zener(v_breakdown=3.6 i_breakdown=0.005)
.ENDL
.control | ;control

tran 10n 20u uic
plot out
.endc
.end

B.1.1. simulación de señal triangular

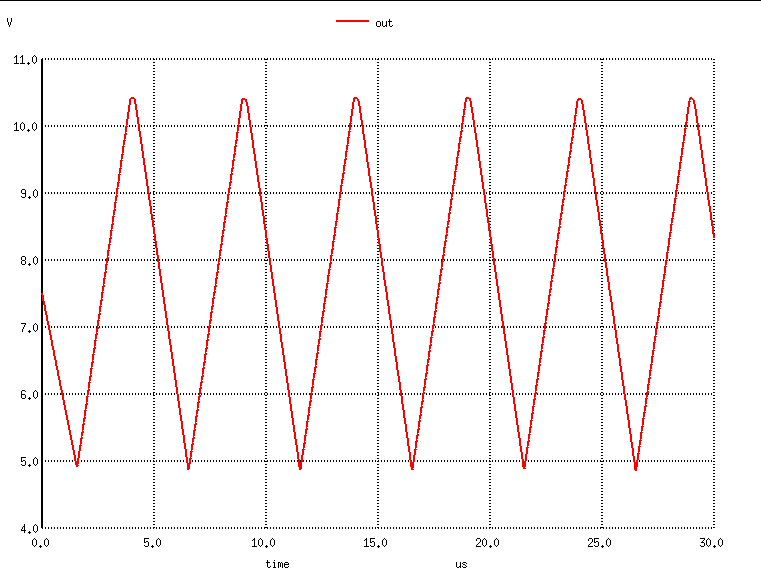
[picture p24: figure]

Figura B.1: señal triangular

mayo 2017 | Documento nº 2: Anexos | página 18 de 55

Jairo Estefanía | Amplificador de clase D

B.1.2. Observaciones

En la figura B.1 se puede observar que la señal sobrepasa los 10V . Ésto se debe a los tiempos de propagación de la señal a través de los Bjts y del propio 555 y nos genera principalmente 2 problemas.

El primero es que al tardar la señal más tiempo en cambiar la pendiente, necesariamente el periodo de la señal se hace mayor, dificultando la obtención de un periodo rápido.

El segundo problema es más grave, ya que si la señal triangular alcanza una tensión lo suficientemente elevada, puede provocar que la tensión del colector del Bjt de tipo P (componente Q2), sea superior a su tensión en la base, lo que hace que el Bjt pase a estado de saturación desestabilizando la señal triangular y por consiguiente, el resto del circuito, que a su vez, podria provocar la destrucción de la carga, en este caso, un cono.

## B.2. Adaptador de señales y generación de PWM

.TITLE Filtro para la señal triangular

.INCLUDE lib/third_party.lib

V1 vcc 0 15
V2 vss 0 -15
V_s | trian_sig 0 PULSE(5 10 0 2u 2u 1n 4u)
V_a | audio_in 0 SIN(0 1.5 1000 0 0)

X_filter vcc vss trian_sig audio_in out PWM_pos PWM_neg PRE_FILTER .LIB FILTER_AND_PMW
.SUBCKT PRE_FILTER vcc vss trian_sig audio_in trian_filt PWM_pos PWM_neg
*AMP_OPE | no_inv | inv | vcc | vss | out | model
X_TL084_1A trian_sig | sig_OA1 | vcc | vss | sig_OA1 | TL084
X_TL084_1B 0 | no_inv2 | vcc | vss | trian_filt TL084
C03 | sig_OA1 | sig_OA1C | 10n | IC=7.5
R7 sig_OA1C | no_inv2 12000
R10 no_inv2 | trian_filt 12000
*AMP_OPE | no_inv | inv | vcc | vss | out | model
X_TL084_1C | audio_in | audio_no_inv vcc | vss | audio_no_inv TL084
X_TL084_1D | 0 | OA_1D_no_inv vcc | vss | audio_inv | TL084
mayo 2017 | Documento nº 2: Anexos | página 19 de 55

Jairo Estefanía | Amplificador de clase D
R8 | audio_no_inv | OA_1D_no_inv | 12000
R9 | OA_1D_no_inv | audio_inv | 12000

X_LM319_A vcc trian_filt audio_no_inv PWM_pos LM319 X_LM319_B vcc trian_filt audio_inv PWM_neg LM319 .ENDS

.SUBCKT LM319 vcc v_no_inv v_inv out
.param Vlow = 0
E_LM319 out 0 Vol = V(v_no_inv) < V(v_inv) ? Vlow : V(Vcc) .ends

.ENDL
.control

options ;RELTOL=0.00001
tran 10n 10u uic
plot trian_sig out

tran 10n 100u uic

plot audio_in out pwm_neg PWM_pos+0.1 .endc
.end
mayo 2017 | Documento nº 2: Anexos | página 20 de 55

Jairo Estefanía | Amplificador de clase D

B.2.1. Simulación

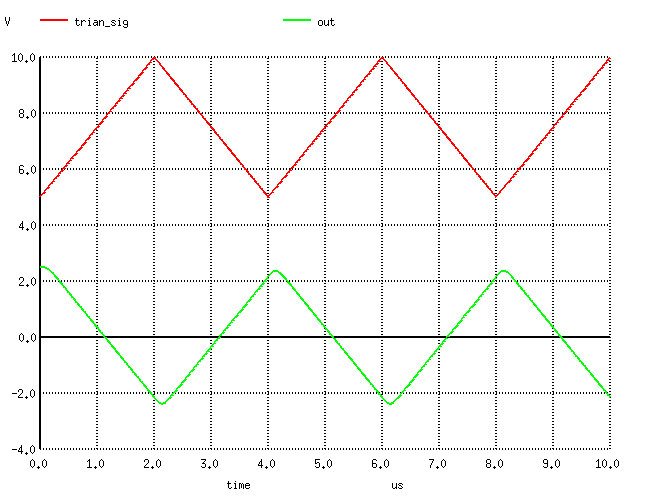
[picture p25: figure]

Figura B.2: filtrado de la señal triangular

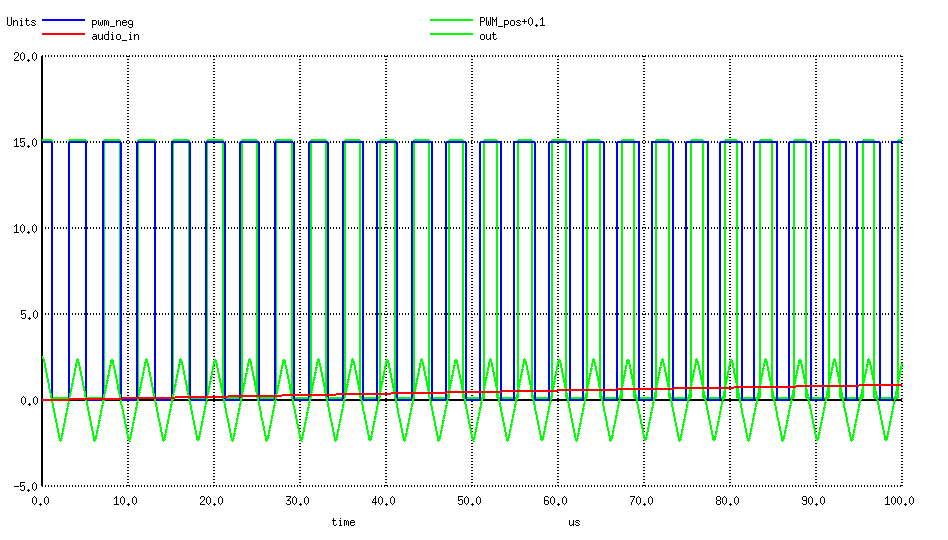
[picture p26: figure]

Figura B.3: Filtrado de señal triangular y generación de PWM

mayo 2017 | Documento nº 2: Anexos | página 21 de 55

Jairo Estefanía | Amplificador de clase D

B.2.2. Observaciones

En la figura B.2 se puede ver como en los extremos de la señal triagular filtrada, aparece una ligera distorsión armónica introducida por un amplificador operacional. Ésta distorsión va a condicionar un factor de modulación que influirá directamente en el rendimiento del equipo, y en la THD, si se introduce un factor de modulación demasiado alto.
En la figura B.3 se puede observar como varian los dos PWM en función de la señal de audio. Nótese que cuando la señal de audio es próxima a cero, los dos PWM tienen un duty cycle próximo al 50 %, y cuando la señal de audio va tomando cierto valor, un PWM aumenta el duty cycle mientras que el otro lo disminuye.

## B.3. Generador de tiempos muertos

* Generador de tiempos muertos para MOSFETS

******************************************************************************** * Descripcion: Generador de tiempos muertos para poder atacar a los Mosfets. ********************************************************************************

v_pwm pwm 0 pulse(15 0 0 1n 1n 5u 10u)

x_dead_time PWM out1 out2 dead_time
.lib deadtime
.SUBCKT dead_time PWM out1 out2

xschmitt1 pwm nodo1 schmitt_neg
R1 nodo1 nodo2 2700
C1 nodo2 0 10p;100p
xschmitt2 nodo2 nodo3 schmitt_neg

xschmitt3 nodo1 nodo4 schmitt_neg R2 nodo4 nodo5 2700
C2 nodo5 0 10p; 100p
xschmitt4 nodo5 nodo6 schmitt_neg
xand1 nodo3 nodo4 out1 | and1
xand2 nodo1 nodo6 out2 | and1
.ends

.subckt schmitt_neg in out aschmitt in nb schmitt
xinversor3 nb out inversor
mayo 2017 | Documento nº 2: Anexos | página 22 de 55

Jairo Estefanía | Amplificador de clase D

.ends

.subckt and1 in1 in2 out
aadc_1 [in1] [in1d] adc
aadc_2 [in2] [in2d] adc
aand_1 [in1d in2d] dand and adac_1 [dand] [out] dac
.ends

.subckt inversor in out
aadc_1 [in] [ind] adc
anot_1 ind n_ind inverter
adac_1 [n_ind] [out] dac
.ends

.model schmitt hyst(in_low=8.8 in_high=5.8
+ hyst=0 out_lower_limit=0.1 out_upper_limit=14.9) .model and d_and
.model inverter d_inverter
.model adc adc_bridge(in_low = 7.4 in_high=7.5)
.model dac dac_bridge(out_low = 0.1 out_high=14.9 out_undef = 2.5) .endl
.control

tran 10n 20u
plot pwm v(out1)+16 V(out2)+16.1

.endc
.end
mayo 2017 | Documento nº 2: Anexos | página 23 de 55

Jairo Estefanía | Amplificador de clase D

B.3.1. Simulación

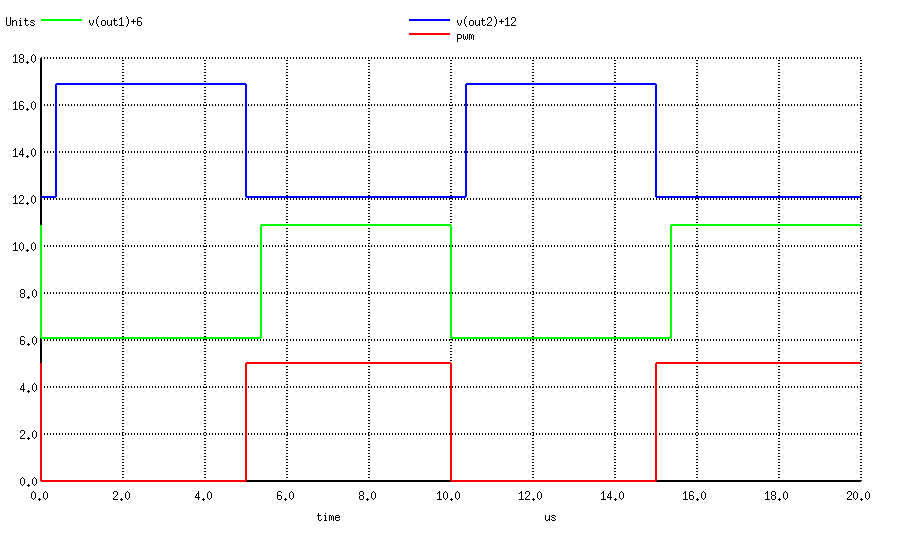
[picture p27: figure]

Figura B.4: Generador de tiempos muertos

B.3.2. Observaciones

En la figura B.4 se puede observar un tiempo ’muerto’ entre una señal PWM y su inversa. Éste tiempo es necesario, tal y como se describe en la memoria, pero habrá que tener en cuenta las diferencias entre los cálculos y la realidad, debido a las tolerancias en las resistencias, los condensadores y la tensión de histéresis.

## B.4. Mosfets y driver de potencia

Drivers and Mosfets

********************************************************************************
* | Descripcion: driver IR2010 MOSFETS filtro de salida y carga
* | Ultima modificacion: | 28 febrero 2017
********************************************************************************

.INCLUDE lib/555_jai_model.sub
.INCLUDE lib/third_party.lib
.LIB lib/IR2010_jai.sub IR2010LIB
.LIB generador_triangular.sub 555
.LIB generador_de_senales_PWM.sub FILTER_AND_PMW
.lib dead_time_v3.sub deadtime
mayo 2017 | Documento nº 2: Anexos | página 24 de 55

Jairo Estefanía | Amplificador de clase D
V1 | vcc 0 15 | ; alimentación de
V2 | Vss 0 -15 | ; circuito de señal
V3 | audio_in 0 SIN(0 2.3 1000 0 0) | ; y entrada de audio
V4 | VEE 0 100 | ; Alimentacion de potencia
V555 out_555 0 PULSE(5 10 0 2u 2u 1n 4u)

*X_555 vcc out_555 TRIANGULAR_SIGNAL
X_FILTER vcc vss out_555 audio_in trian_filt PWM_fase PWM_contrafase PRE_FILTER X_dead_time_A PWM_fase out1_A out2_A dead_time
X_dead_time_B PWM_contrafase out1_B out2_B dead_time

x_IR2010_A out1_A out2_A HO_A LO_A VS_A 0 IR2010
x_IR2010_B out1_B out2_B HO_B LO_B VS_B 0 IR2010

R15 HO_A ng_q4 10
R16 LO_A ng_q5 10
R17 HO_B ng_q6 10
R18 LO_B ng_q7 10

M_Q4 VEE ng_q4 VS_A VS_A MOSFETN;IXFH36N55Q
M_Q5 VS_A ng_q5 0 | 0 | MOSFETN;IXFH36N55Q

M_Q6 VEE ng_q6 VS_B VS_B MOSFETN;IXFH36N55Q
M_Q7 VS_B ng_q7 0 | 0 | MOSFETN;IXFH36N55Q

L1 VS_A speak_fase 35u

L2 VS_B speak_contrafase 35u
C6 speak_fase 0 | 100p
C7 0 speak_contrafase | 100p
C8 speak_fase speak_contrafase 560p

RL speak_fase speak_contrafase 8

.model MOSFETN NMOS level=1 VTO=4.6 Kp = {2*14.4294} RD=0.19 .control
options interp ;reltol = 0.1 TRTOL=1 interp
tran 10u 2014u 1014u uic
.endc
.end
mayo 2017 | Documento nº 2: Anexos | página 25 de 55

Jairo Estefanía | Amplificador de clase D

B.4.1. Simulación

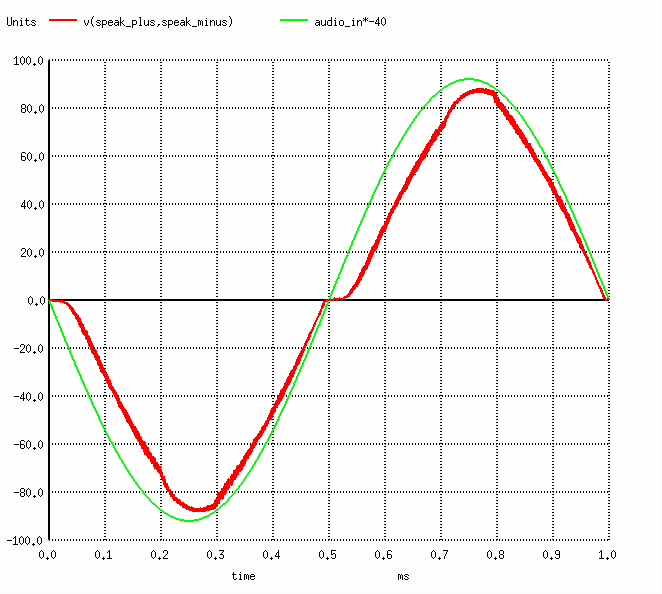
[picture p28: figure]

Figura B.5: Salida del circuito con unos tiempos muertos de 350ns

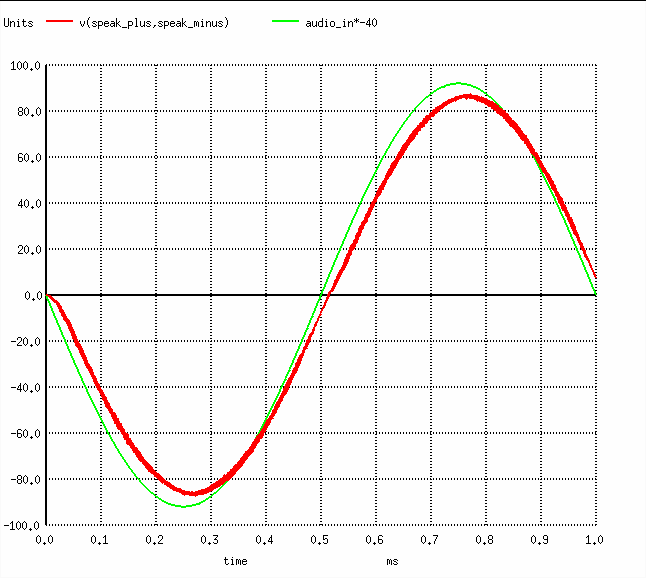
[picture p29: figure]

Figura B.6: Salida del circuito con unos tiempos muertos de 30ns

mayo 2017 | Documento nº 2: Anexos | página 26 de 55

Jairo Estefanía | Amplificador de clase D

B.4.2. Observaciones

En la figura B.5 se puede observar como unos tiempos excesivamente grandes producen una distorsión de cruce considerable.

mayo 2017 | Documento nº 2: Anexos | página 27 de 55

Jairo Estefanía | Amplificador de clase D
mayo 2017 | Documento nº 2: Anexos | página 28 de 55

Jairo Estefanía | Amplificador de clase D

# Anexo C: Ensayos

Los ensayos en laboratorio, se han realizado con una carga de 5,1Ω y con otra carga de 10,5Ω.

Se ha usado una fuente de tensión dual de ±15V para alimentar la parte de control, una fuente de tensión para la parte de potencia que se ha ido variando desde los 20V hasta los 60V y un generador de funciones para simular una entrada de audio a 1kHz.
Todas las fuentes han compartido la misma referencia.

## C.1. Señal triangular

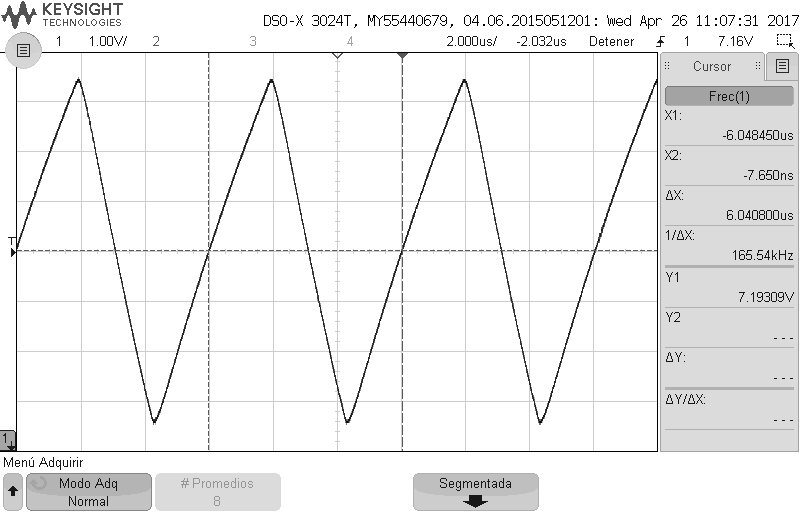
[picture p30: figure]

Figura C.1: Señal trianguar

Tensión pico-a-pico = 6,8V pp

Frecuencia = 165kHz

Observaciones: La tensión pico a pico es bastante mayor que la tensión ideal de 5Vpp. Si la tensión fuese menor a la tensión de puerta del BJT Q3 tipo N y viceversa para el tipo P, el circuito puede llegar a destruir la carga. En caso de poner varias vias de audio, se destruiria el altavoz con mayores graves.
La frecuencia máxima hallada para este circuito de manera experimental es de 174kHz sin que el circuito se haga inestable. En cualquier
mayo 2017 | Documento nº 2: Anexos | página 29 de 55

Jairo Estefanía | Amplificador de clase D

caso, la frecuencia de 165kHz es una frecuencia lo suficientemente elevada para ofrecer una buena respuesta.

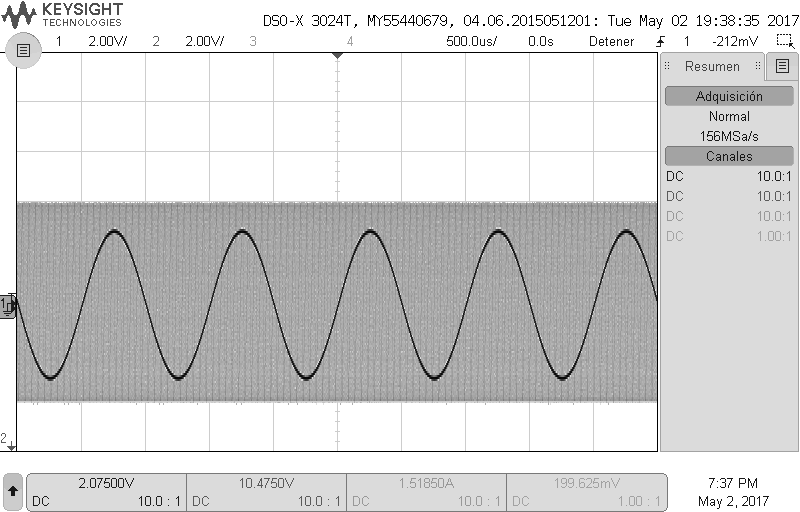
[picture p31: figure]

Figura C.2: Modulacion

## C.2. Factor de modulación

Tensión de audio = 2,93Vp

Tensión de la señal triangular = 3,9V

Factor de modulación = 75 %

Observaciones: El factor de modulación viene limitado en cierta parte por la etapa de generación de tiempos muertos, y además, es dependiente de las fuentes de entrada y sus niveles de tensión (RCA, XLR balanceado, XLR-no-balanceado, etc). En este ensayo, este factor se ha regulado de manera manual, perp debe ser regulado en una etapa preamplificadora.

mayo 2017 | Documento nº 2: Anexos | página 30 de 55

Jairo Estefanía | Amplificador de clase D

## C.3. Tiempos muertos

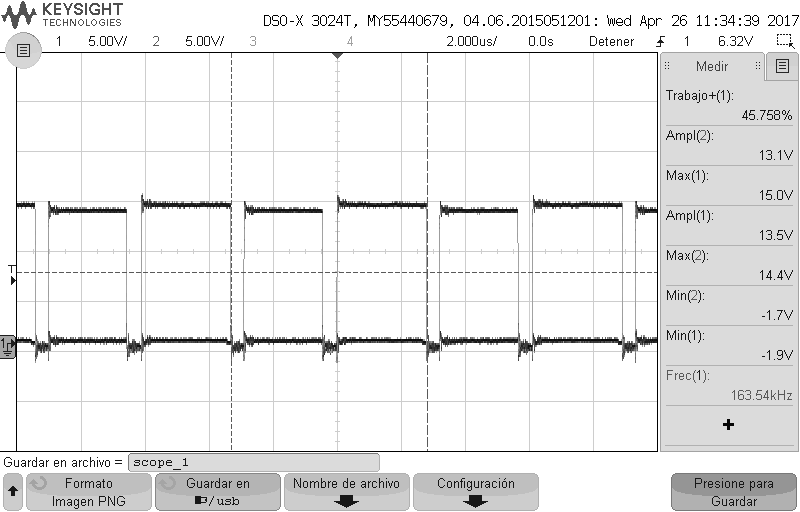
[picture p32: figure]

Figura C.3: Tiempos muertos

Tiempos muertos = 375ns

Observaciones: Los tiempos muertos obtenidos son sustancialmente superiores a los calculados de forma teórica debido a las no-idealidades del circuito. Seria deseable realizar unos test especificos a los MOSFETS para poder hallar los tiempos mínimos para los cuales no se produzcan cortocircuitos en corriente, con el fin de mejorar notablemente tanto la distorsión en la salida como la generación de armónicos de alta frecuencia a la fuente de alimentación.

mayo 2017 | Documento nº 2: Anexos | página 31 de 55

Jairo Estefanía | Amplificador de clase D

## C.4. Niveles de tensión de puerta en los MOS-FETS

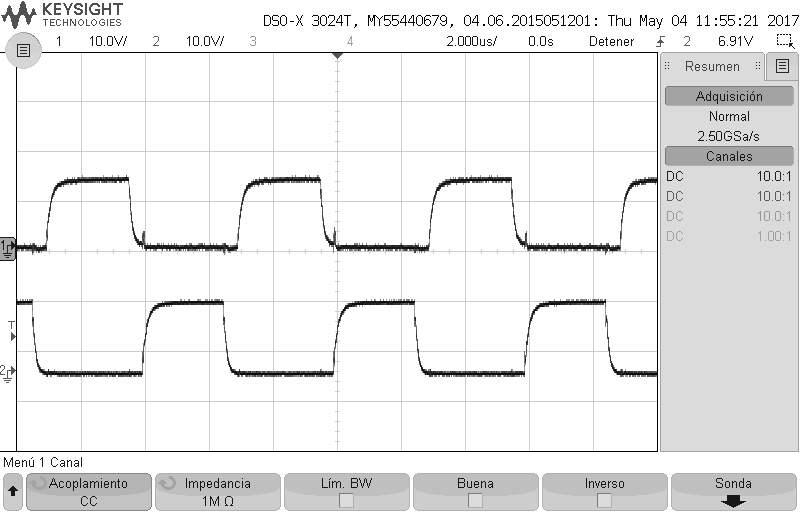
[picture p33: figure]

Figura C.4: Tension VGS en los MOSFETS

Observaciones: Los niveles de tensión en la puerta de los MOSFETs son los esperados. Se podria conseguir una respuesta sutilmente más rápida disminuyendo el valor de las resistencias de puerta R15, R16, R17 y R18, pero también seria aconsejable aumentar potencia de las mismas.

mayo 2017 | Documento nº 2: Anexos | página 32 de 55

Jairo Estefanía | Amplificador de clase D

## C.5. Carga de 5,1Ω

C.5.1. 20V

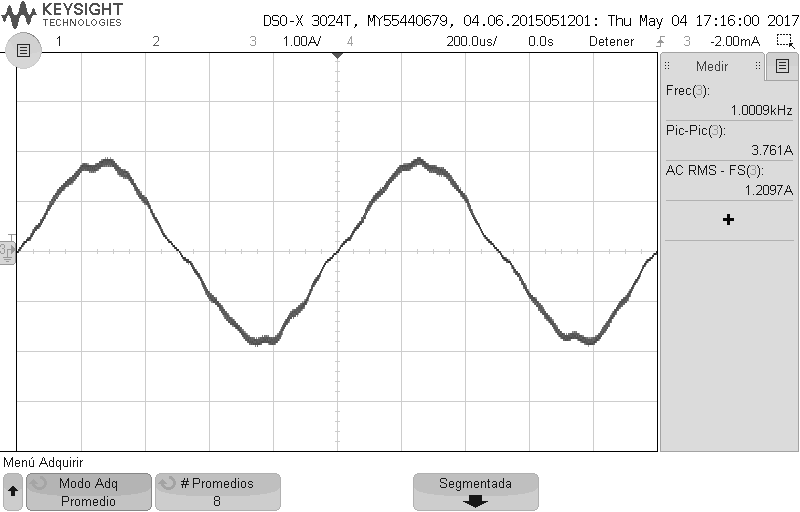
[picture p34: figure]

Figura C.5: Tensión de 20V. Irms = 1,2A

Potencia de la fuente = 12,3W

Intensidad RMS = 1,2A

Potencia en carga = I

2
RMS · R = 7,34W

Rendimiento = = 59,7 %

mayo 2017 | Documento nº 2: Anexos | página 33 de 55

Jairo Estefanía | Amplificador de clase D

C.5.2. 30V

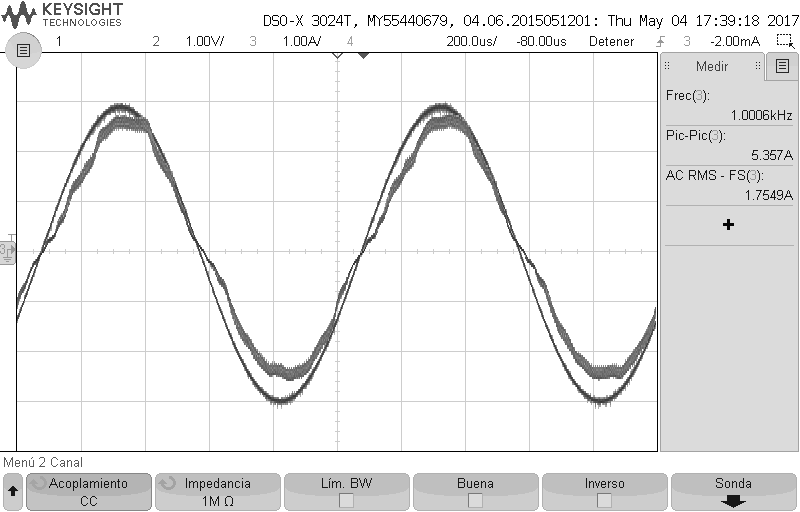
[picture p35: figure]

Figura C.6: Tensión de entrada: 30V . IRMS = 1,75A

Potencia de la fuente = 28W

Intensidad RMS = 1,75A

Potencia en carga = I

2
RMS · R = 15,62W

Rendimiento = = 55,7 %

mayo 2017 | Documento nº 2: Anexos | página 34 de 55

Jairo Estefanía | Amplificador de clase D

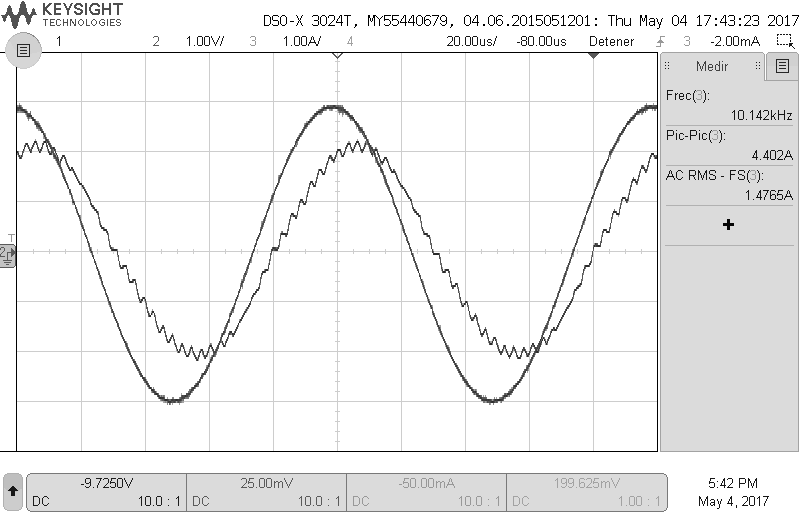
[picture p36: figure]

Figura C.7: 10kHz

C.5.3. 40V

Potencia de la fuente = 45W

Intensidad RMS = 2,33A

Potencia en carga = I

2
RMS · R = 22,69W

Rendimiento = 61,53 %

mayo 2017 | Documento nº 2: Anexos | página 35 de 55

Jairo Estefanía | Amplificador de clase D

C.5.4. 50V

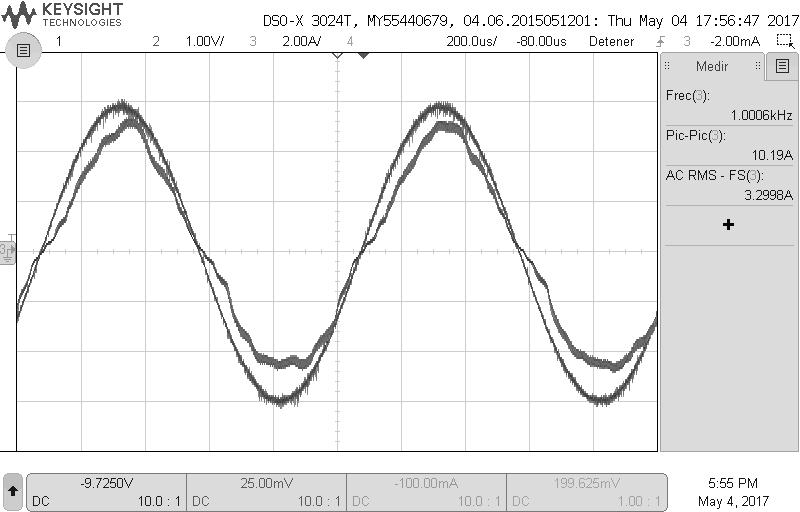
[picture p37: figure]

Figura C.8: Tensión de entrada: 50V . IRMS = 3,30A

Potencia de la fuente = 80W

Intensidad RMS = 3,30A

Potencia en carga = I

2
RMS · R = 55,54W

Rendimiento = 69,42 %

mayo 2017 | Documento nº 2: Anexos | página 36 de 55

Jairo Estefanía | Amplificador de clase D

## C.6. Carga de 10,8Ω

C.6.1. 40V

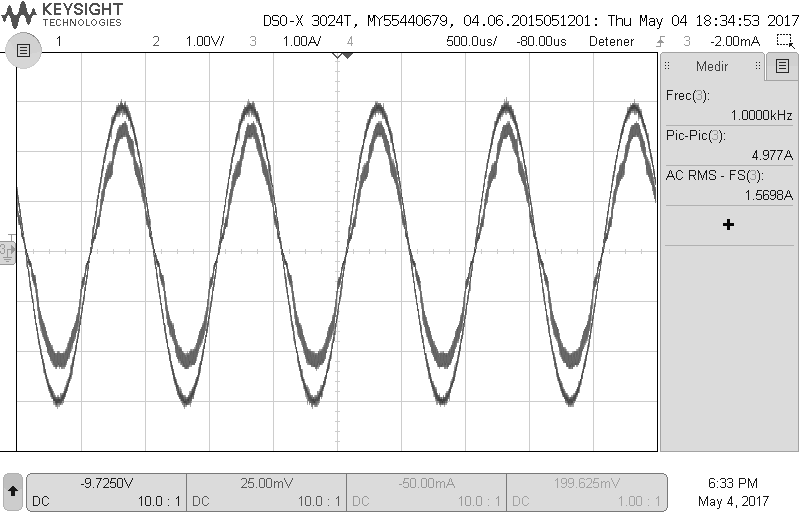
[picture p38: figure]

Figura C.9: 40V

Potencia de la fuente = 32W

Intensidad RMS = 1,57A

Potencia en carga = I

2
RMS · R = 26,62W

Rendimiento = 83,19 %

mayo 2017 | Documento nº 2: Anexos | página 37 de 55

Jairo Estefanía | Amplificador de clase D

C.6.2. 50V

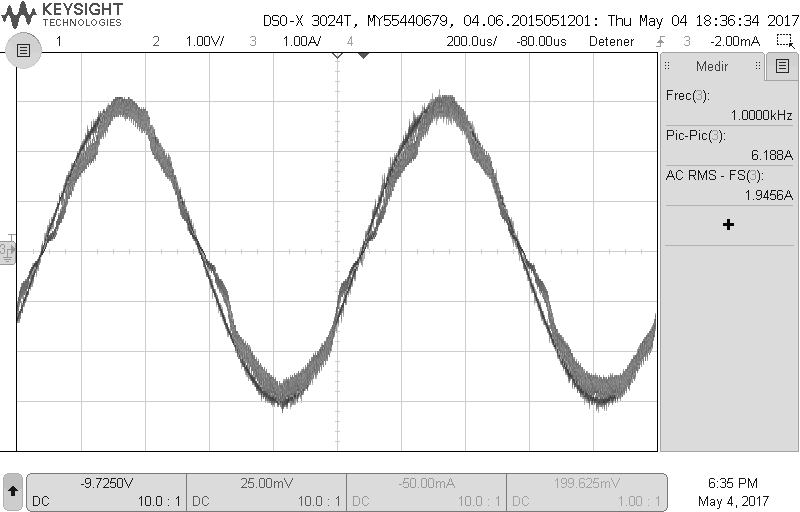
[picture p39: figure]

Figura C.10: 50V

Potencia de la fuente = 50W

Intensidad RMS = 1,95A

Potencia en carga = I

2
RMS · R = 41,07W

Rendimiento = 82,13 %

mayo 2017 | Documento nº 2: Anexos | página 38 de 55

Jairo Estefanía | Amplificador de clase D

C.6.3. 60V

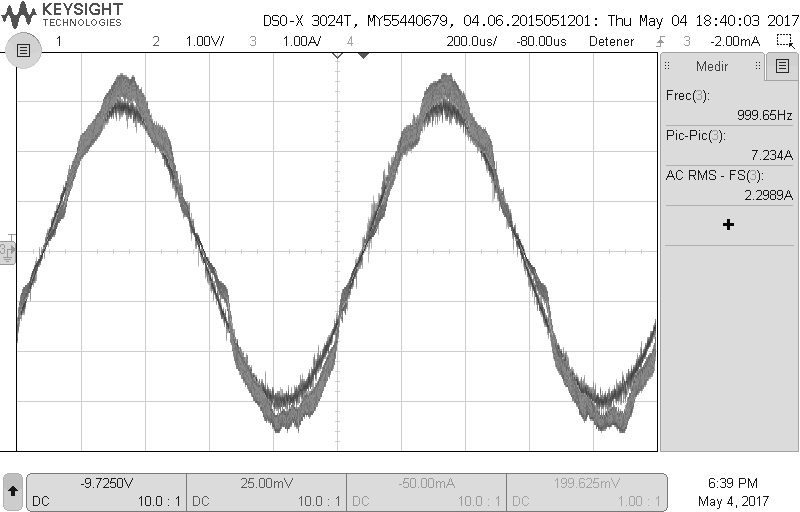
[picture p40: figure]

Figura C.11: Tensión de entrada: 60V . IRMS = 2,3A

Potencia de la fuente = 70W

Intensidad RMS = 2,3A

Potencia en carga = I

2
RMS · R = 57,13W

Rendimiento = 81,62 %

mayo 2017 | Documento nº 2: Anexos | página 39 de 55

Jairo Estefanía | Amplificador de clase D

C.6.4. 70V

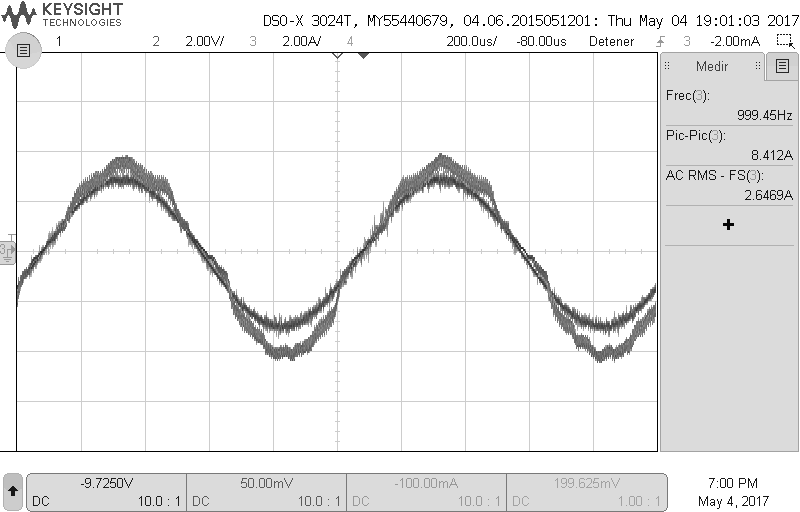
[picture p41: figure]

Figura C.12: Tensión de entrada: 70V . IRMS = 2,65A

Potencia de la fuente = 90W

Intensidad RMS = 2,65A

Potencia en carga = I

2
RMS · R = 75,84W

Rendimiento = 84,27 %

mayo 2017 | Documento nº 2: Anexos | página 40 de 55

Jairo Estefanía | Amplificador de clase D

## C.7. Cámara térmica

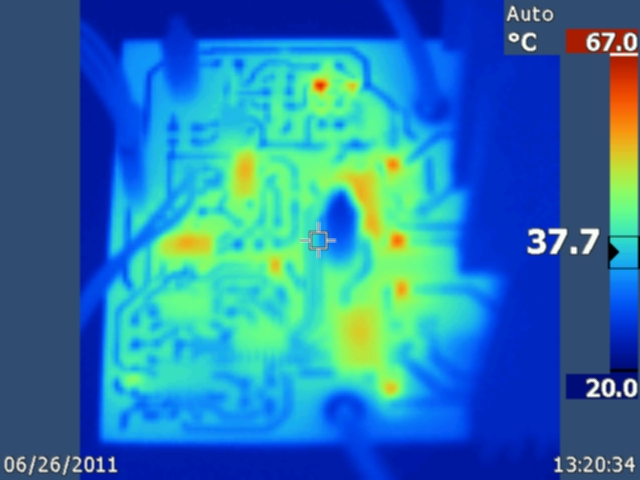
[picture p42: figure]

Figura C.13: Imágen térmica

Los componentes en la parte de contros permanecen estables a niveles de temperatura tolerables. Debido a que los ensayos se han realizado con una relativa baja potencia y a un correcto dimensionamiento de los disipadores, los MOSFETs y la parte de potencia apenas han aumentado su temperatura.

## C.8. Conclusiones

En las capturas con el osciloscopio, se observa un rizado a alta frecuencia muy pequeño en comparación con la componente de audio. Además se observa una pequeña distorsión de 50Hz proveniente de la red eléctrica, a pesar de haber usado una fuente de alimentación profesional.

mayo 2017 | Documento nº 2: Anexos | página 41 de 55

Jairo Estefanía | Amplificador de clase D
mayo 2017 | Documento nº 2: Anexos | página 42 de 55

Jairo Estefanía | Amplificador de clase D

# Anexo D: Esquemáticos

mayo 2017 | Documento nº 2: Anexos | página 43 de 55

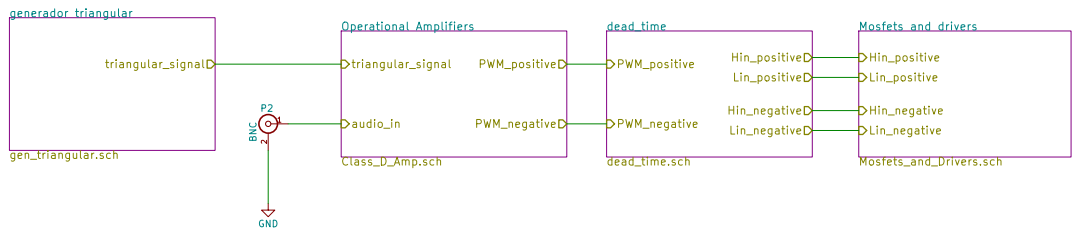
[picture p43: page 70]
D Date: 2017-02-14 KiCad E.D.A. kicad 4.0.5 Size: A4; Rev: 0.2; Class_D_Amp.sch; audio_in; PWM_positive; PWM_negative; triangular_signal; generador triangular; gen_triangular.sch; Hin_positive; Lin_positive; Hin_negative; Lin_negative; dead_time; dead_time.sch

2 P2 BNC GND Mosfets and drivers Mosfets_and_Drivers.sch

Jairo Estefanía Vilumbrales Operational Amplifiers

File: class_D_ampl.sch Sheet: / Universidad de Cantabria

Id: 1/5 Title: Esquéma general

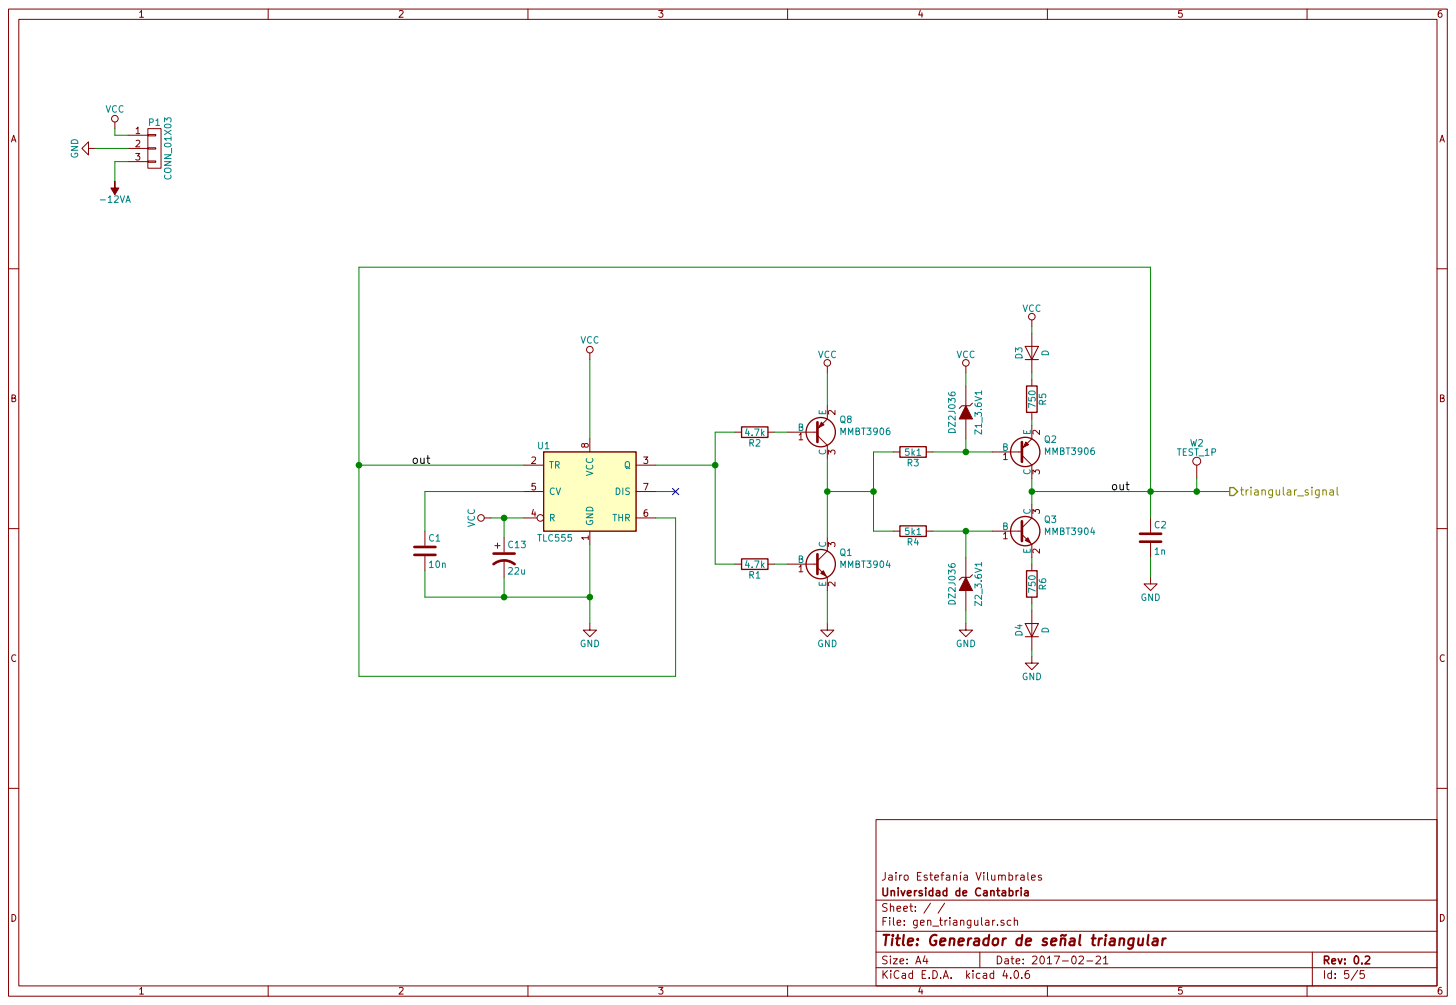
[picture p44: page 71]

Jairo Estefanía Vilumbrales GND

File: gen_triangular.sch Sheet: / / Universidad de Cantabria

Id: 5/5 Title: Generador de señal triangular

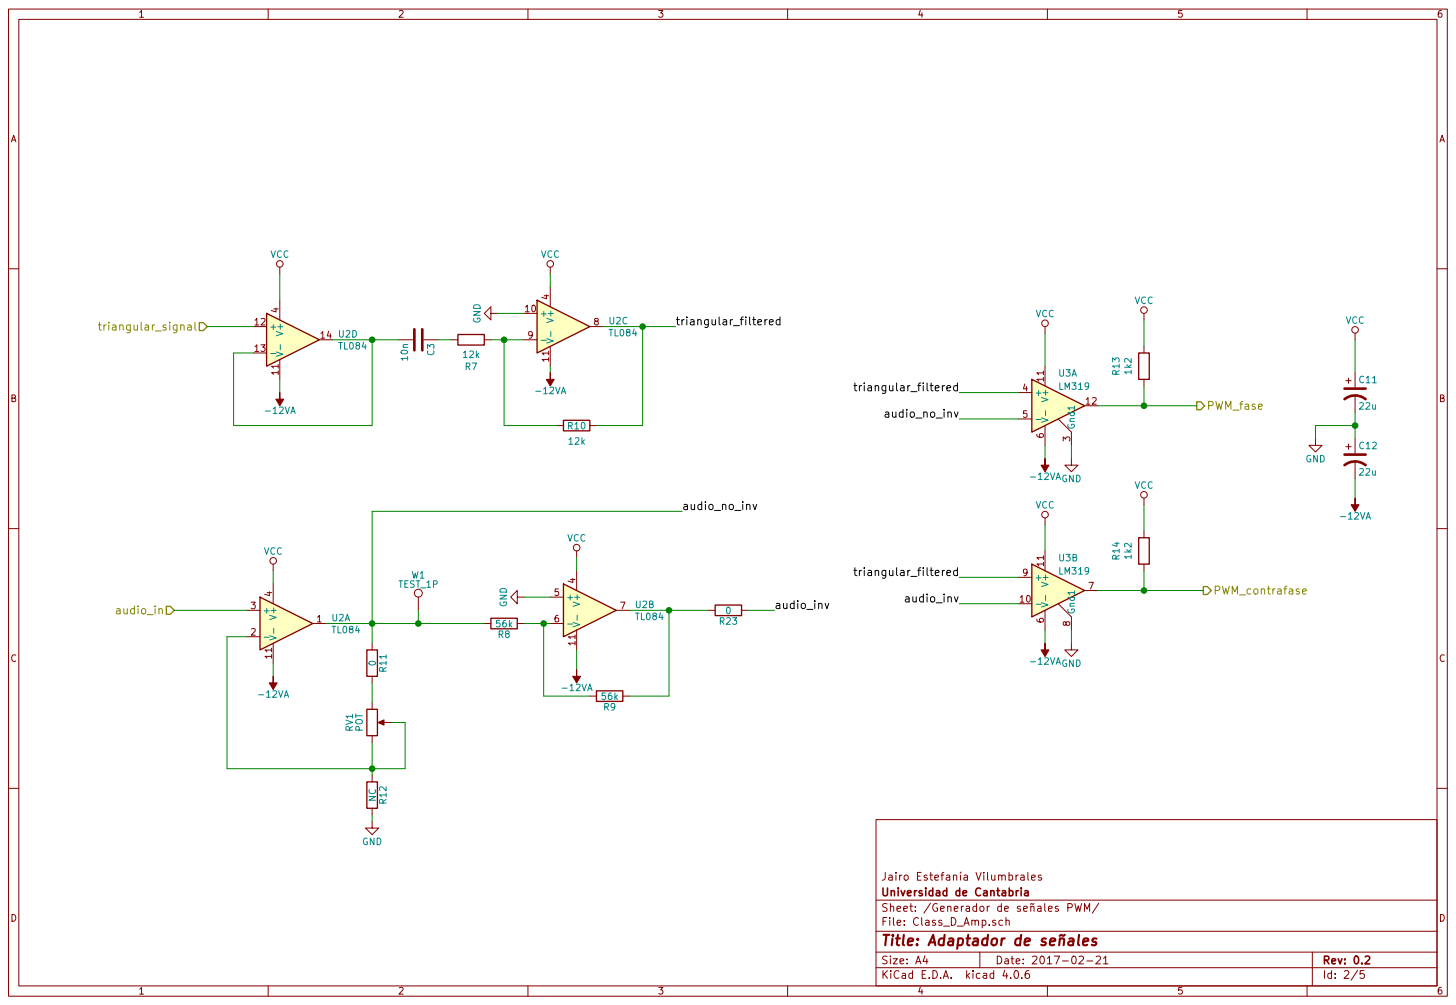
[picture p45: page 72]

Jairo Estefanía Vilumbrales
File: Class_D_Amp.sch Sheet: /Generador de señales PWM/ Universidad de Cantabria

Id: 2/5 Title: Adaptador de señales

100p R22

# 100p GNDGND

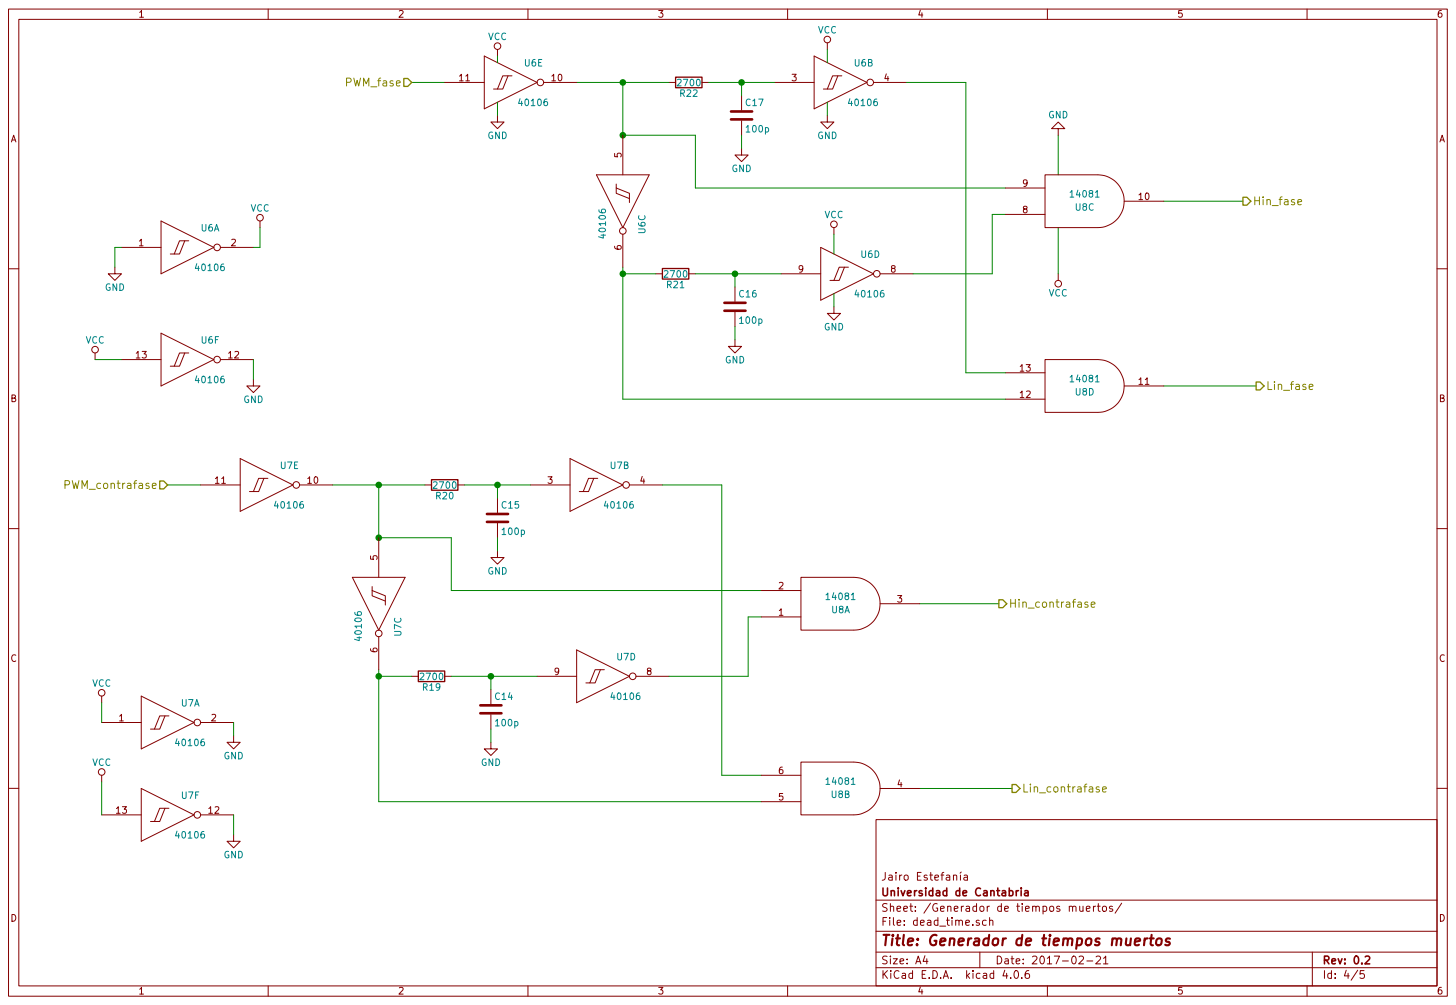
[picture p46: page 73]

Jairo Estefanía
Sheet: /Generador de tiempos muertos/ Universidad de Cantabria

File: dead_time.sch
Id: 4/5 Title: Generador de tiempos muertos

# VEE GNDPWR GNDPWR

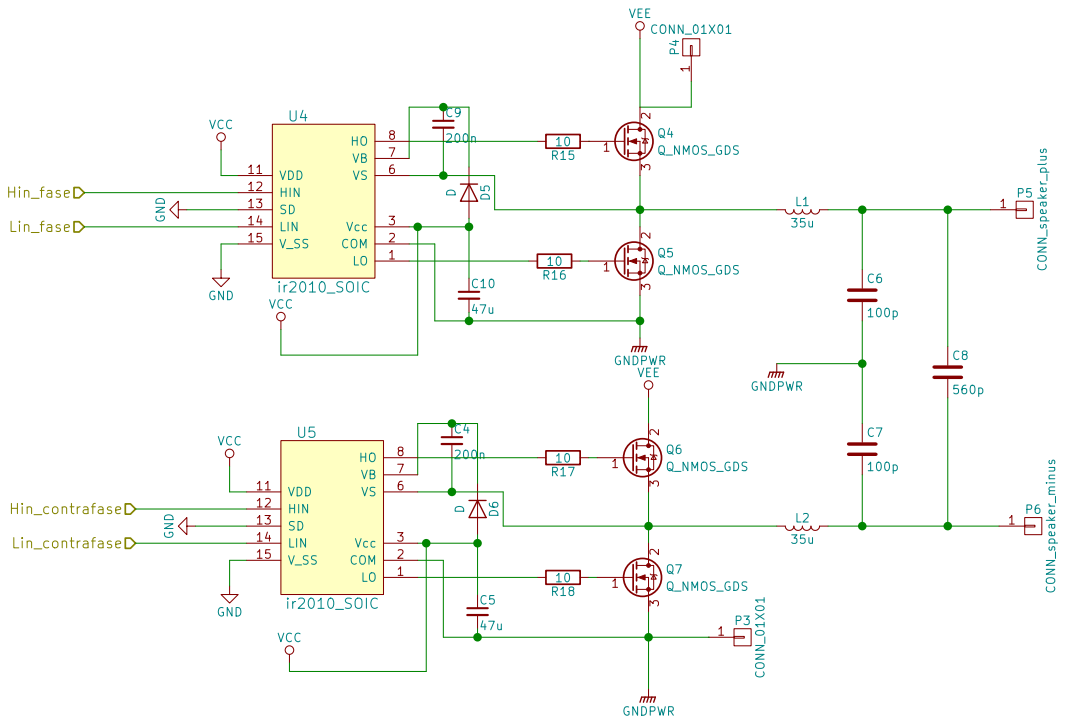
[picture p47: page 74]

Jairo Estefanía Vilumbrales
Sheet: /Drivers y MOSFETS de potencia/ Universidad de Cantabria

File: Mosfets_and_Drivers.sch
Id: 3/5 Title: Mosfets y Drivers

Jairo Estefanía | Amplificador de clase D

# Anexo E: Ficheros PCB y Gerbers

mayo 2017 | Documento nº 2: Anexos | página 49 de 55

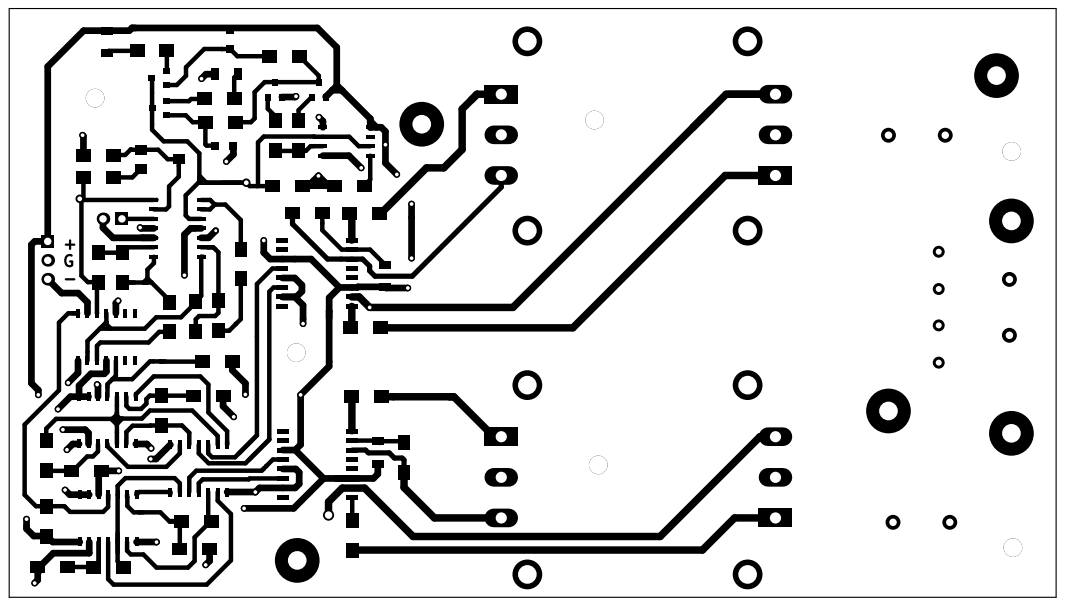
[picture p48: page 76]

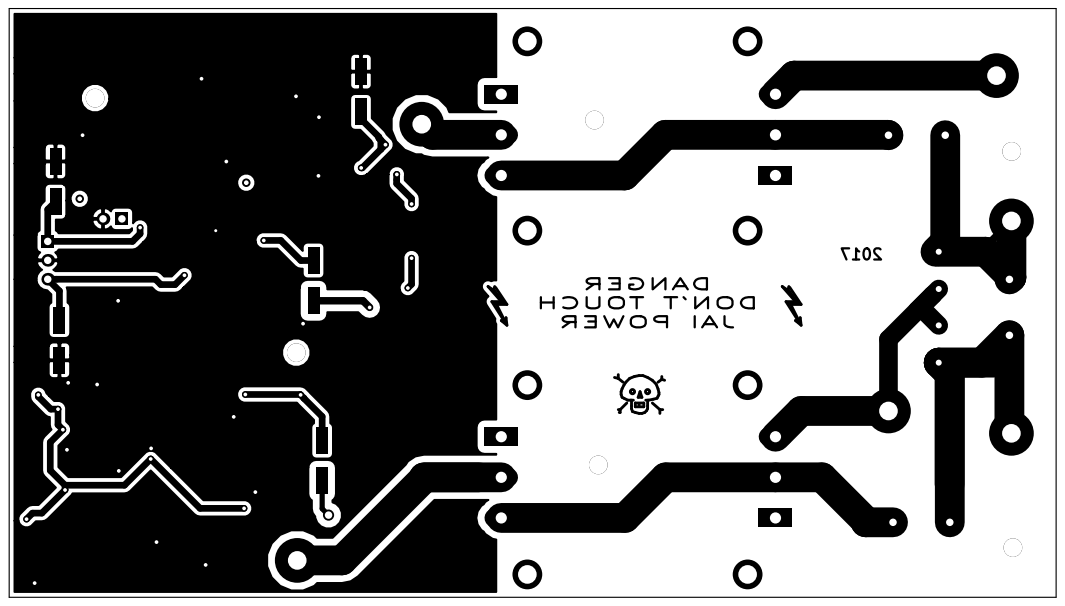
[picture p49: page 77]

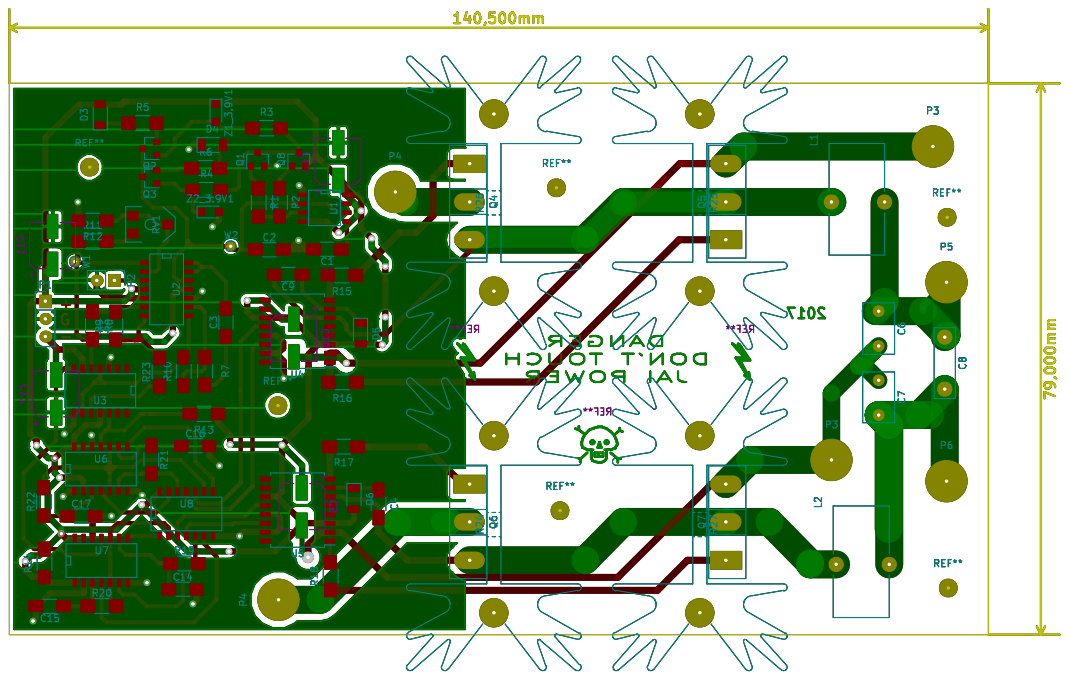
[picture p50: page 78]

Jairo Estefanía | Amplificador de clase D

# Anexo F: Análisis de competencia

## F.1. the t.amp Proline 3000

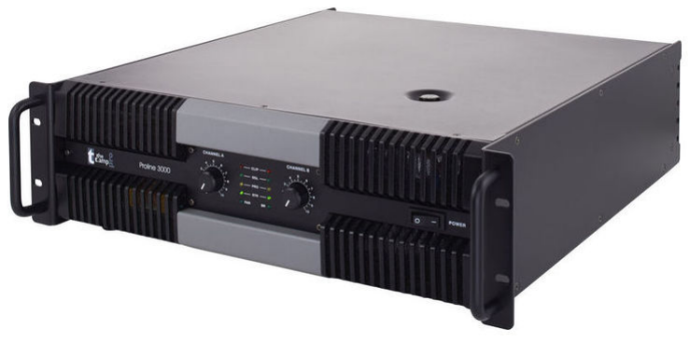
[picture p51: figure]

Figura F.1: t.amp Proline 3000

P.V.P.: 645 e
2 x 1500W a 4 Ohmios
2 x 1100W a 8 Ohmios
2 x 1800W a 2 Ohmios
Dimensiones: 482 x 480 x 132mm (19/3U) Peso: 37kg

## F.2. the t.amp E-800

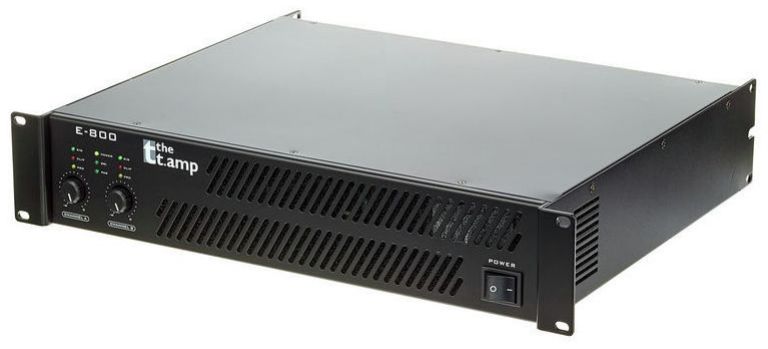
[picture p52: figure]

Figura F.2: the t.amp E-800

P.V.P.: 158 e2x 500W a 4 Ohms, 2x 350W a 8 ohms (1kHz, THD<=0.1 %) Modo puenteado: 1x 800W a 8 Ohms
Rango de frecuencias thomann 20Hz-20kHz
mayo 2017 | Documento nº 2: Anexos | página 53 de 55

Jairo Estefanía | Amplificador de clase D

Medidas: 482 x 375 x 88mm
Peso: 11,3 Kg

## F.3. Behringer KM750

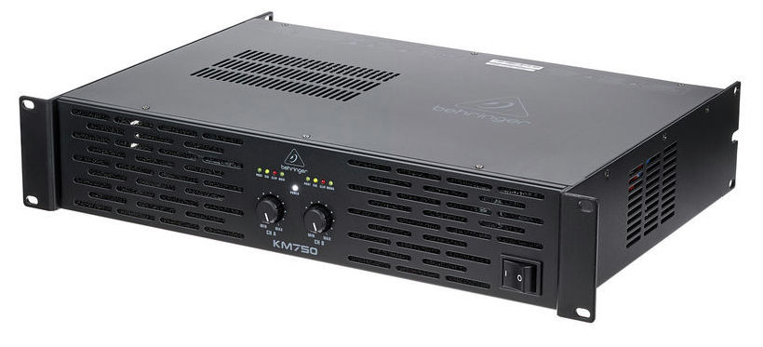
[picture p53: figure]

Figura F.3: Behringer KM750

P.V.P.: 148e
2x 400W / 4 Ohmios RMS
2x 200W / 8 Ohmios RMS
750W / 8 Ohmios RMS (bridge) Formato: 19/2U
Peso: 8,5kg

## F.4. Crown XLS 2500

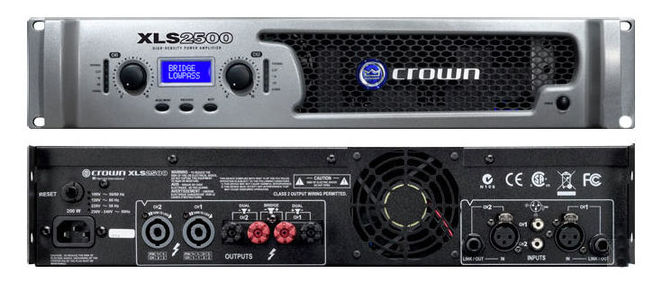
[picture p54: figure]

Figura F.4: Crown XLS 2500

P.V.P.: 477e
Digital Class-D
mayo 2017 | Documento nº 2: Anexos | página 54 de 55

Jairo Estefanía | Amplificador de clase D

2x 775 W/4 Ohm, 2x 440 W/8 OHm, 2x 1200 W/2 Ohm
2 canales estéreo o mono puenteado
Chasis de aluminio 19/2HE Profundidad: 27,2 cm Peso 4,9 Kg
mayo 2017 | Documento nº 2: Anexos | página 55 de 55

# Documento III

# Pliego de Condiciones

1

Jairo Estefanía | Amplificador de clase D

# 1 Condiciones legales

Copyright Jairo Estefanía Vilumbrales <cerverros@gmail.com>2017.

This documentation describes Open Hardware prototype.

This document is licensed under the Attribution-NonCommercial-NoDerivatives 4.0 International (CC BY-NC-ND 4.0) https://creativecommons.org/licenses/by-nc-nd/4.0/legalcode

The hardware and the related files to hardware (Kicad sources, and ngspice simulations with the exception of third-party libraries) are licensed under the CERN OHL v. 1.2. and are release at http://github.com/zerberros/Class_D_Amp (http://github.com/zerberros/Class_D_Amp)

You may redistribute and modify this proyect under the terms of the CERN OHL v.1.2. (http://ohwr.org/cernohl).

This proyect is distributed WITHOUT ANY EXPRESS OR IMPLIED WARRANTY, INCLUDING OF MERCHANTABILITY, SATISFACTORY QUALITY AND FITNESS FOR A PARTICULAR PURPOSE. Please see the CERN OHL v.1.2 for applicable conditions.

mayo 2017 | Documento nº 3: Pliego de condiciones | página 3 de 3

# Documento IV

# PRESUPUESTO

1

Jairo Estefanía | Amplificador de clase D

# Índice general

IV PRESUPUESTO | 1
mayo 2017 | Documento nº 4: Presupuesto | página 3 de 7

Jairo Estefanía | Amplificador de clase D

# Índice de cuadros

mayo 2017 | Documento nº 4: Presupuesto | página 4 de 7

Jairo Estefanía | Amplificador de clase D

## 1.1. Coste directo

### 1.1.1. Mano de obra

Cuadro 1.1: Mano de obra
Coste/hora | Horas Totales | Total
Ingeniero Junior | 20 | 380 | 7600
Ingeniero Senior | 40 | 16 | 640
Coste Total de mano de obra | | | 8240

### 1.1.2. Materias primas

Cuadro 1.2: Materias Primas
Referencia | Descripción | c/u | u | Total
TLC555 | Máquina del tiempo SMD | 0.796 | 1 | 0.80
MMBT3904 | Transistor BJT SMD | 0.0928 | 2 | 0.19
MMBT3906 | Transistor BJT SMD | 0.123 | 2 | 0.25
ir2010 | Driver MOSFETS | 3.36 | 2 | 6.72
0077071A7 | Toroide ferromagnético | 1.70 | 2 | 3.40
LM319 | Comparador | 1.58 | 1 | 1.58
40106 | disparador de Schmitt | 0.413 | 2 | 0.83
14081 | puertas AND | 0.509 | 1 | 1.02
TL084 | Amplificador operacional | 0.607 | 1 | 0.61
BZX384-B3V6 | Diodo Zener 3.6V | 0.0572 | 2 | 0.11
TS4148 RX | Diodo pequeña señal | 0.0469 | 2 | 0.09
MC1206B10 3K102CT | Condensador SMD 1206 10n | 0.201 | 2 | 0.40
12062A101 JAT2A | Condensador SMD 1206 100p | 0.225 | 4 | 0.90
MC1206B102 2K202CT | Condensador SMD 1206 1n | 0.0592 | 1 | 0.06
MCHP06W2FXXXXT5E | Resistencia SMD 1206 varios valores | 0.174 | 23 | 4.00
TSM4ZL501 KR10 | Potenciómetro de ajuste | 4.84 | 1 | 4.84
677-20ABP | Disipador térmico | 2.67 | 4 | 10.68
IXTH 36N50P | MOSFET N 36A 500V 160mohm | 5.98 | 5 | 23.92
PCB (min. 5uds) | 100x160mm 2 caras cobre 70um | 54 | 5 | 54
H07Z1-K | Cable hilo flexible 2.5mm | 0.308 | 1 | 0.31
AWG-14 | Hilo esmaltado | 0.208 | 2 | 0.41
Total coste de componentes | | | | 115.12
mayo 2017 | Documento nº 4: Presupuesto | página 5 de 7

Jairo Estefanía | Amplificador de clase D

### 1.1.3. Puesto de trabajo

Cuadro 1.3: Software
Software | Descripción | Coste
Antergos | Sistema operativo | 0
Kicad | Diseño PCBs | 0
NGSPICE | Simulación electrónica | 0
python | Lenguaje de Script | 0
Conda | Conjunto de bibliotecas cientificas para python | 0
git | Control de versiones | 0
TexLive | Motor Latex | 0
Texstudio | IDE Latex | 0
Inkscape | Diseño vectorial 2D | 0
FreeCAD | Diseño 3D | 0
Total Coste de Licencias por Software | | 0

Cuadro 1.4: Herramientas y material de trabajo
Herramienta | Descripción | Coste
DSOX1102A Keysight | Osciloscopio digital | 722
TIS10 | Cámara térmica | 1435
VictSing 60W | Cautín | 18
Thoshiba Satellite Z30 | Ordenador portátil | 999
Mohoo FY3224S | Generador de funciones | 44
Labps3100sm Cetronic | Fuente de alimentacion laboratorio | 177
Nr-7192 Cetronic | Multimetro digital | 20
Dremel 3000 | Minitaladro | 50
Herramientas varias | Destornilladores, alicates, tijeras, etc | 50
Total Coste de Herramientas y materiales | | 3515

Estimación de vida útil 7 años

Estimación de duracción del proyecto 3 meses

Coste de amortización = 3515e ·

3 meses
84meses = 125e

## 1.2. Costes indirectos

### 1.2.1. Mano de obra

Para la mano de obra indirecta se ha considerado un coste de un 3 % respecto a la de la mano de obra directa.

mayo 2017 | Documento nº 4: Presupuesto | página 6 de 7

Jairo Estefanía | Amplificador de clase D

Cuadro 1.7: Coste Total
Costes | Total
Coste directo | 8480.12
Mano de obra | 8240
Materias primas | 115.12
Puesto de trabajo | 125
Costes indirectos | 2670
Mano de obra | 247
Otros gastos | 2423
Coste total del proyecto | 11150.12

Cuadro 1.5: Mano de obra indirecta
Descripción | Coste
Mano de obra indirecta | 247
Total Coste de mano de obra indirecta | 247

### 1.2.2. Otros gastos

En otros gastos se contabiliza el coste del alquiler de un local, calefacción, gastos de luz y agua, ya gastos de envio. Se estima un coste de un 25 % respecto al coste del proyecto. Alquiler de local

Cuadro 1.6: Otros gastos
Descripción | Coste
Mano de obra indirecta | 2423
Total otros gastos | 2423

## 1.3. Coste total del proyecto

El coste total del proyecto asciende a oncemil ciento cincuenta euros con doce centimos. 11150.12e

mayo 2017 | Documento nº 4: Presupuesto | página 7 de 7
