zerberros/Class_D_Amp/KiCAD/class_D_ampl.kicad_pcb

## KiCad design KiCAD/class_D_ampl.kicad_pcb (2017-05-21)

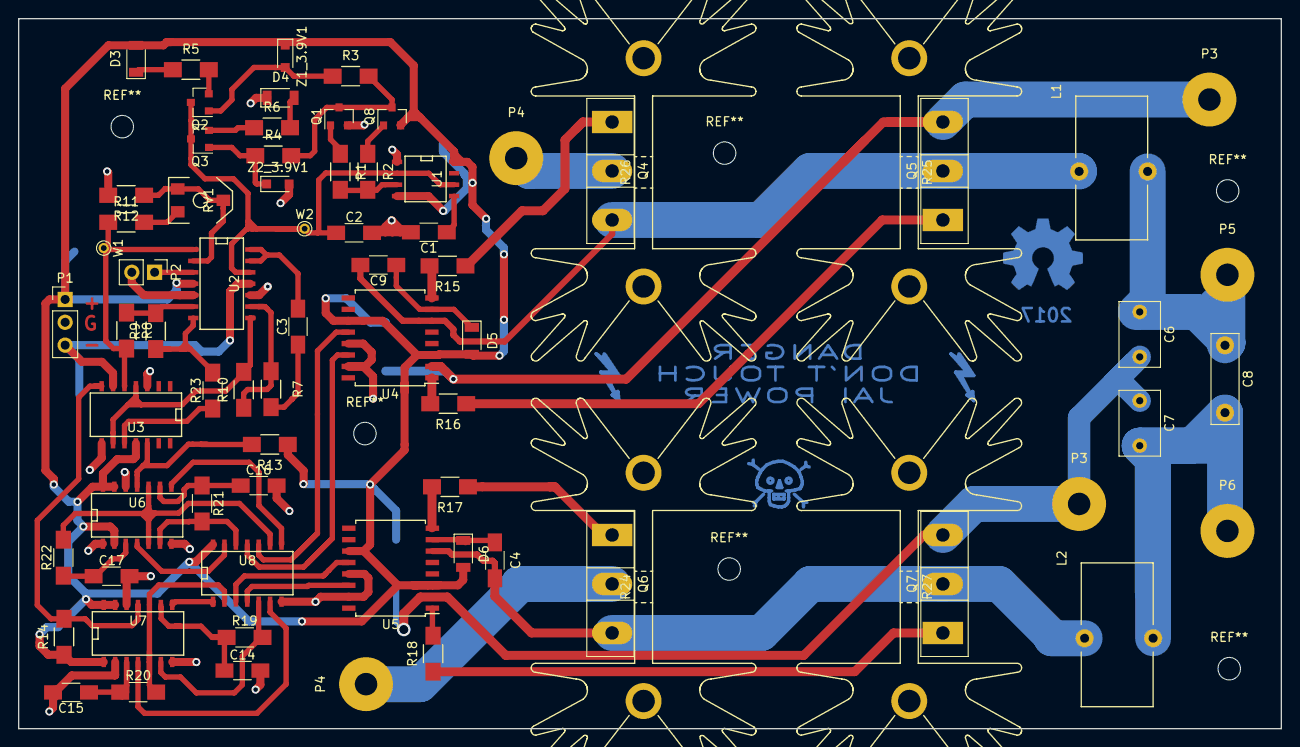
[picture p55: board class_D_ampl.kicad_pcb from above]

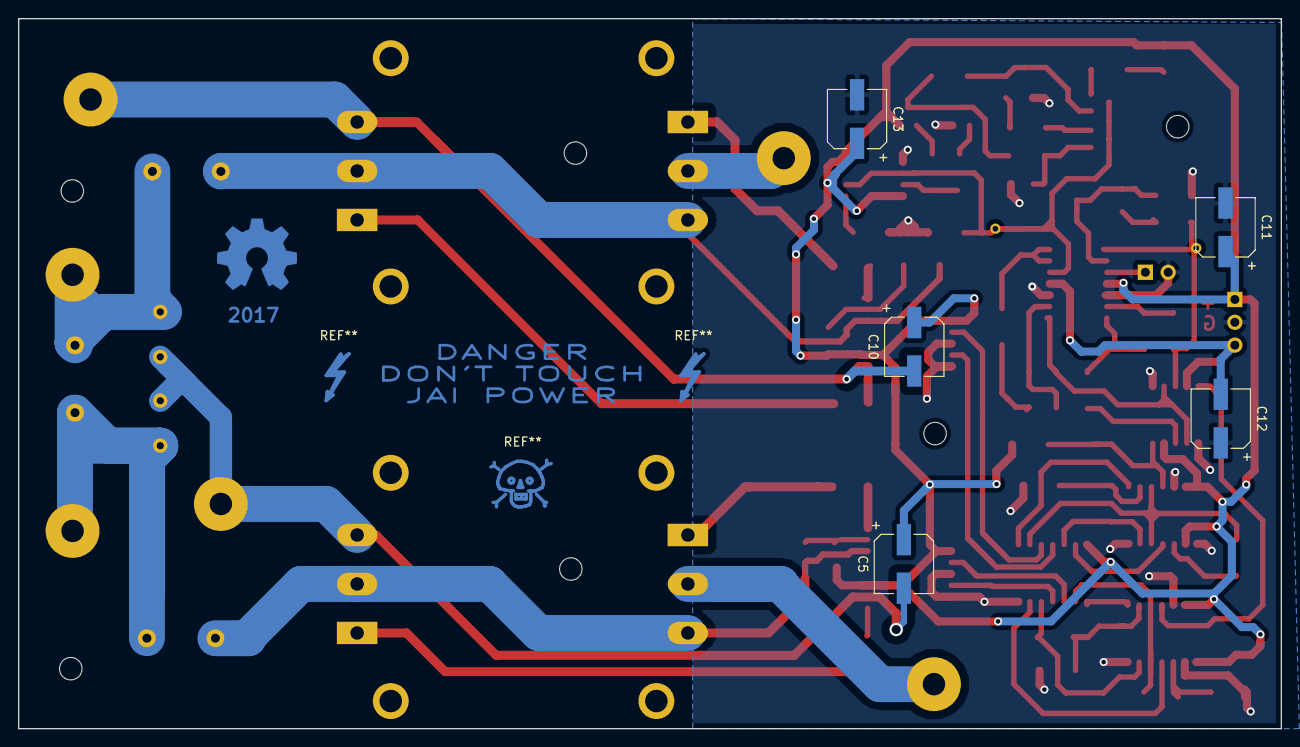
[picture p56: board class_D_ampl.kicad_pcb from below]

Board: 2 copper layers, 140.5 x 79.0 mm, 79 parts (5 on the bottom side), 60 nets.

Parts:
C1, C2, C3: 10n; C_1206_HandSoldering
C4, C9: 100n; C_1206_HandSoldering
C5, C10: 47u; CP_Elec_6.3x5.8
C6, C7: 100p; C_Rect_L7.2mm_W4.5mm_P5.00mm_FKS2_FKP2_MKS2_MKP2
C8: 560p; C_Rect_L10.0mm_W3.0mm_P7.50mm_FKS3_FKP3
C11, C12, C13: 22u; CP_Elec_6.3x5.8
C14, C15, C16, C17: 100p; C_1206_HandSoldering
D3, D4, D5, D6: D; D_1206
L1, L2: 35u; Choke_Toroid_8x16mm_Vertical
P1: CONN_01X03; Pin_Header_Straight_1x03_Pitch2.54mm
P2: BNC; Pin_Header_Straight_1x02_Pitch2.54mm
P3, P3#2, P4, P4#2: CONN_01X01; SolderWirePad_single_2-5mmDrill
P5: CONN_speaker_plus; SolderWirePad_single_2-5mmDrill
P6: CONN_speaker_minus; SolderWirePad_single_2-5mmDrill
Q1, Q3: MMBT3904; SOT-23
Q2, Q8: MMBT3906; SOT-23
Q4, Q5, Q6, Q7: Q_NMOS_GDS; TO-247_TO-3P_Vertical
R1, R2: 4.7k; R_1206_HandSoldering
R3, R4: 100k; R_1206_HandSoldering
R5, R6: 4.7; R_1206_HandSoldering
R7, R10: 12k; R_1206_HandSoldering
R8, R9: 56k; R_1206_HandSoldering
R11, R23: 0; R_1206_HandSoldering
R12: NC; R_1206_HandSoldering
R13, R14: 1k2; R_1206_HandSoldering
R15, R16, R17, R18: 10; R_1206_HandSoldering
R19, R20, R21, R22: 3300; R_1206_HandSoldering
R24, R25, R26, R27: Heater; Heatsink_Fischer_SK129-STS_42x25mm_2xDrill2.5mm
RV1: POT; POT_SMD
U1: TLC555; SOIC-8-N
U2: TL084; SOIC-14_N
U3: LM319; SOIC-14_N
U4, U5: ir2010_SOIC; SOIC-16W_7.5x10.3mm_Pitch1.27mm
U6, U7: 40106; SOIC-14_N
U8: 14081; SOIC-14_N
W1, W2: TEST_1P; PINTST
Z1_3.9V1, Z2_3.9V1: DZ2J039; D_SOD-323_HandSoldering

Connections:
-12VA: C12.2, P1.3, U2.11, U3.6
/Mosfets and drivers/Hin_negative: U5.12, U8.3
/Mosfets and drivers/Hin_positive: U4.12, U8.10
/Mosfets and drivers/Lin_negative: U5.14, U8.4
/Mosfets and drivers/Lin_positive: U4.14, U8.11
/Operational Amplifiers/PWM_negative: R14.2, U3.7, U7.11
/Operational Amplifiers/PWM_positive: R13.2, U3.12, U6.11
/Operational Amplifiers/audio_in: P2.1, U2.3
/Operational Amplifiers/audio_inv: R23.1, U3.10
/Operational Amplifiers/audio_no_inv: R8.2, R11.1, U2.1, U3.5, W1.1
/Operational Amplifiers/triangular_filtered: R10.2, U2.8, U3.4, U3.9
/Operational Amplifiers/triangular_signal: C2.1, Q2.3, Q3.3, U1.2, U1.6, U2.12, W2.1
GND: C1.2, C2.2, C11.2, C12.1, C13.2, C14.2, C15.2, C16.2, C17.2, D4.1, P1.2, P2.2, Q1.2, R12.2, U1.1, U2.5, U2.10, U3.3, U3.8, U4.13, U4.15, U5.13, U5.15, U6.1, U6.7, U6.12, U7.2, U7.7, U7.12, U8.7, Z2_3.9V1.2
GNDPWR: C5.2, C6.2, C7.1, C10.2, P3.1, P3#2.1, Q5.3, Q7.3, U4.2, U5.2
unnamed: C1.1, U1.5
unnamed: C3.1, R7.2
unnamed: C3.2, U2.13, U2.14
unnamed: C4.1, D6.1, U5.7
unnamed: C4.2, L2.2, Q6.3, Q7.2, U5.6
unnamed: C6.1, C8.1, L1.1, P5.1
unnamed: C7.2, C8.2, L2.1, P6.1
unnamed: C9.1, D5.1, U4.7
unnamed: C9.2, L1.2, Q4.3, Q5.2, U4.6
unnamed: C14.1, R19.1, U7.9
unnamed: C15.1, R20.1, U7.3
unnamed: C16.1, R21.1, U6.9
unnamed: C17.1, R22.1, U6.3
unnamed: D3.1, R5.1
unnamed: D4.2, R6.2
unnamed: Q1.1, R1.1
unnamed: Q1.3, Q8.3, R3.2, R4.2
unnamed: Q2.1, R3.1, Z1_3.9V1.2
unnamed: Q2.2, R5.2
unnamed: Q3.1, R4.1, Z2_3.9V1.1
unnamed: Q3.2, R6.1
unnamed: Q4.1, R15.1
unnamed: Q5.1, R16.1
unnamed: Q6.1, R17.1
unnamed: Q7.1, R18.1
unnamed: Q8.1, R2.1
unnamed: R1.2, R2.2, U1.3
unnamed: R8.1, R9.2, U2.6
unnamed: R7.1, R10.1, U2.9
unnamed: R11.2, RV1.3
unnamed: R12.1, RV1.1, RV1.2, U2.2
unnamed: R15.2, U4.8
unnamed: R16.2, U4.1
unnamed: R17.2, U5.8
unnamed: R18.2, U5.1
unnamed: R19.2, U7.6, U8.5
unnamed: R20.2, U7.5, U7.10, U8.2
unnamed: R21.2, U6.6, U8.12
unnamed: R22.2, U6.5, U6.10, U8.9
unnamed: R9.1, R23.2, U2.7
unnamed: U6.4, U8.13
unnamed: U6.8, U8.8
unnamed: U7.4, U8.6
unnamed: U7.8, U8.1
VCC: C5.1, C10.1, C11.1, C13.1, D3.2, D5.2, D6.2, P1.1, Q8.2, R13.1, R14.1, U1.4, U1.8, U2.4, U3.11, U4.3, U4.11, U5.3, U5.11, U6.2, U6.13, U6.14, U7.1, U7.13, U7.14, U8.14, Z1_3.9V1.1
VEE: P4.1, P4#2.1, Q4.2, Q6.2
