zerberros/Class_D_Amp/(commit log)

2017-05-21 Add KiCad files
    [Class_D_Amp.sch, Mosfets_and_Drivers.sch, PWM_mod.sch, class_D_ampl.kicad_pcb, class_D_ampl.sch, dead_time.sch, gen_triangular.sch]
2017-05-21 change the library for a zener
    [Class_D_Amp.sch, Mosfets_and_Drivers.sch, class_D_ampl.sch, dead_time.sch, gen_triangular.sch]
